jeffraines/battlebuddy/docs/roadmap.md

# Roadmap

Two products from one device:

- **Personal:** one counter per player (or one shared per table). Bought by players.
- **Store / tournament kit:** a set of devices (e.g. 8, 16 or 32) plus a hub, a
  charging tray, and a live dashboard. Bought by stores. Smaller "friends"
  kits (e.g. 4 for a Commander pod) sit in between.

The personal device comes first. The kit shapes a few early hardware choices
(radio, battery, charging, device ID) so PCB v1 doesn't paint us into a corner.

## Design principles

These apply to everything built here, not just BattleBuddy.

1. **The battery is user-replaceable, without tools beyond a coin or a common
   screwdriver.** A dead battery must never make the device e-waste. Prefer a
   standard, widely sold cell or pack over a custom pouch cell.
2. **Repairable.** Screws, not glue. The display, battery and buttons connect
   with connectors, not solder. Spare parts and firmware stay available.
3. **Spill-tolerant, not waterproof.** It should survive a knocked-over drink
   on the table. No official IP rating needed (and don't claim one without testing).

### Replaceable battery options

| Option | Pros | Cons |
|---|---|---|
| Phone-style flat pack (e.g. Nokia BL-5C type, 3.7 V ~1000 mAh, ~53×34×6 mm) | Flat, protected, keyed, spring contacts, sold almost everywhere | Long-term availability of a specific pack type; check it fits each design |
| Small cylindrical Li-ion in a holder (10440 / 16340 / 18650) | Standard sizes, easy to buy, holder is cheap | Thicker; 10440/14500 look like AAA/AA, so mixing them up is a risk |
| 2× AA / AAA (NiMH or alkaline) | Most universal; nothing to charge if you don't want to | Needs a boost converter; bulkier; best for low-power displays (e-paper, reflective) |
| Flat LiPo with a JST plug behind a battery door | Thinnest; what the LilyGO prototype uses | Exact replacement is harder to find; must label size and polarity |

Leaning: a phone-style flat pack for the personal device, an 18650 for a larger
"Max" model.

### Spill tolerance

- A gasket between the display and the enclosure lip; buttons under a
  membrane or with sealed caps.
- USB-C mounted so liquid doesn't run into it (side-facing, recessed), and a
  battery door with a simple seal.
- Conformal coating on the PCB: cheap, and it handles the "wiped it off and it
  still works" case.
- Firmware: ignore touches that look like water (many points at once, large
  contact areas) and offer a touch lock.

### Regulation note

The EU Battery Regulation (2023/1542) requires portable batteries in most
appliances to be removable and replaceable by the end user from February 2027.
That matters if this is ever sold in Europe, and principle 1 already covers it.

## Phases

1. **Prototype firmware** on the LilyGO T-Display-S3 Touch, and play-test it at
   real games. *(In progress: `firmware/tdisplay-s3`.)*
2. **Pick the display and MCU** using the display test kit and battery
   measurements (see `hardware.md`).
3. **PCB v1:** see `pcb-v1.md` for the running requirements list (fuel gauge,
   replaceable battery, wireless charging, display on connectors, and more).
   Designed for low standby current (regulator and charger quiescent current
   matter as much as the MCU's sleep current).
4. **Enclosure:** 3D printed first; injection molding only once the design
   settles. Screwed together, with a tool-light battery door and a display gasket.
5. **Configuration:** phone/web configurator, custom game profiles, sharing.
6. **Tournament kit:** hub, server and dashboard, pairings import, charging tray.

## Tournament mode (concept)

- A tournament server (laptop, Raspberry Pi or cloud) holds players, pairings
  and the round clock.
- Each device has a unique ID (from the chip) and is checked in to a player.
- At round start the server pushes table number, opponent name and a synced
  round timer to each device.
- Score changes stream to the server; a web page shows every table live.
- Both players confirm the result on the device, replacing the match slip.
- Import pairings from existing tournament software rather than replacing it.

### Radio options

| Option | Fits | Notes |
|---|---|---|
| Wi-Fi to a router the store brings | ESP32 | Simplest to build and debug. Avoid venue Wi-Fi (captive portals, flaky). Wi-Fi bursts cost battery, so send small updates and idle the radio. |
| ESP-NOW to one ESP32 hub on the laptop | ESP32 | No router, low latency, good range. |
| BLE advertising to a hub (connectionless) | nRF52 / ESP32 | Each device broadcasts its score; the hub scans, so 32 devices are fine. Pairings go out over short connections. Lowest power; keeps the Nordic option alive. |

A hub is needed in every case. Classic BLE connections to one central don't
scale to 32 devices.

## MCU decision (open)

The MCU is $1–4 of the bill of materials, so pick for headroom; the battery
budget is decided mostly by the display and the board's power design.

| | ESP32-S3 | ESP32-C3 / C6 | nRF52840 |
|---|---|---|---|
| Radios | Wi-Fi + BLE | Wi-Fi + BLE (C6 adds 802.15.4) | BLE (+ proprietary 2.4 GHz) |
| RAM / display | 512 KB + PSRAM, parallel LCD | 400–512 KB, SPI LCD | 256 KB, SPI LCD |
| Sleep | Good (~10 µA chip) | Good | Best |
| Tournament path | Wi-Fi or ESP-NOW | Wi-Fi or ESP-NOW | BLE advertising |

The counter logic (`core/`) is portable C, so either family stays possible.
Decide at PCB time based on measured battery life and which tournament radio
path proves out.

## Charging tray (open)

| Option | Pros | Cons |
|---|---|---|
| Qi receiver per device, one transmitter per tray slot | Sealed enclosure, nice UX | A transmitter per slot adds cost; heat |
| One loosely coupled resonant coil charging several devices | True "drop them on the tray" | Less standard, efficiency varies with placement |
| Pogo pins / magnetic contacts | Cheapest, efficient, simple | Exposed contacts; needs alignment |
