jeffraines/battlebuddy/docs/size-cutouts.pdf

# BattleBuddy - actual-size display cutouts

Print at 100% / Actual size. The bar below must measure 50 mm. Outlines are the visible screen only; boards and cases are larger.

50 mm
20

1.47" LCD (Waveshare C6)
320x172, 33 x 18 mm active area

20

1.54" IPS - the one you own 240x240, 28 x 28 mm active area

20

1.8" AMOLED
448x368, 35 x 29 mm active area
20

1.9" LCD (T-Display S3)
320x170, 43 x 23 mm active area

20

2.0" LCD (Estardyn)
320x240, 41 x 30 mm active area

20

2.13" e-paper / reflective 250x122, 49 x 24 mm active area

2.41" AMOLED

20

600x450, 49 x 37 mm active area

2.7" Sharp Memory LCD

20

400x240, 59 x 35 mm active area
20

2.79" bar LCD (Estardyn)
428x142, 67 x 22 mm active area

2.8" LCD (Cheap Yellow)

20

320x240, 57 x 43 mm active area
20

2.9" e-paper (WeAct)
296x128, 68 x 29 mm active area

20

2.8" LCD - shared
320x240, 57 x 43 mm active area

20

3.5" LCD - shared
480x320, 74 x 49 mm active area
20

4.2" reflective (Osptek) - shared 400x300, 85 x 64 mm active area
