jeffraines/battlebuddy/enclosure/fitcheck.stl

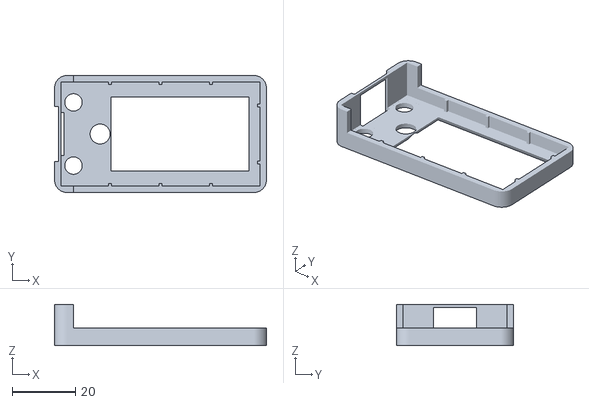
[picture p3: CAD file, 2026-11-08]
enclosure/fitcheck.stl
67.0 x 37.0 x 13.1
