jeffraines/battlebuddy/enclosure/stl/faceplate_r24_split-faceplate-body-separator.stl

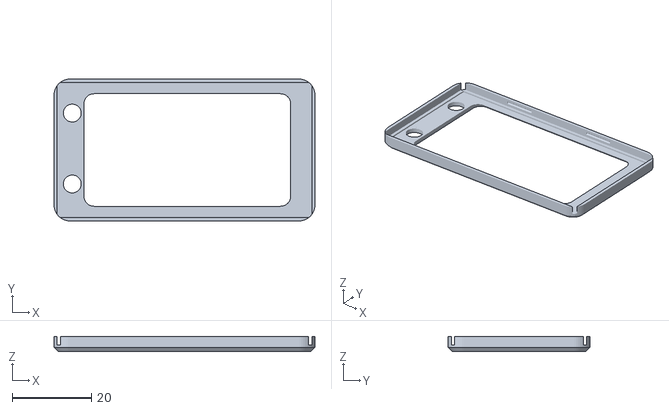
[picture p4: CAD file, 2026-11-14]
enclosure/stl/faceplate_r24_split-faceplate-body-separator.stl
65.7 x 35.7 x 3.70
