jeffraines/battlebuddy/enclosure/shell.stl

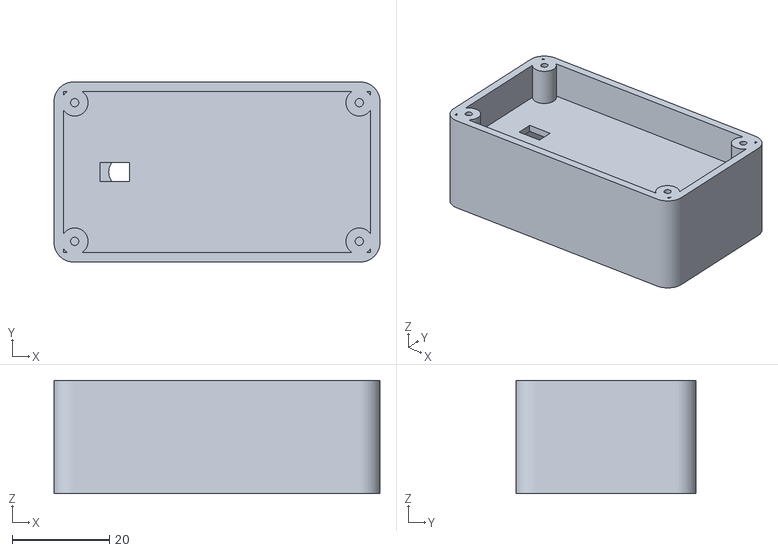
[picture p5: CAD file, 2026-11-08]
enclosure/shell.stl
67.0 x 37.0 x 23.3
