jeffraines/battlebuddy/enclosure/stl/separator_r24_split-faceplate-body-separator.stl

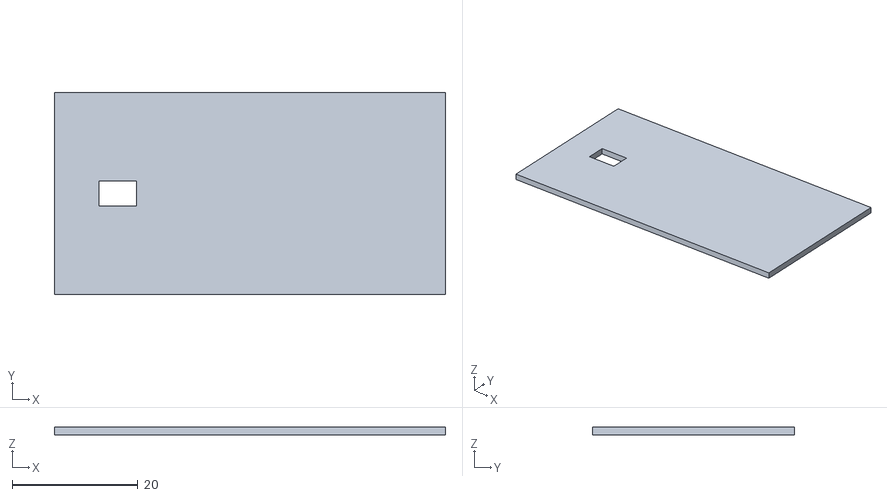
[picture p6: CAD file, 2026-11-14]
enclosure/stl/separator_r24_split-faceplate-body-separator.stl
62.1 x 32.1 x 1.20
