jeffraines/battlebuddy/enclosure/lid.stl

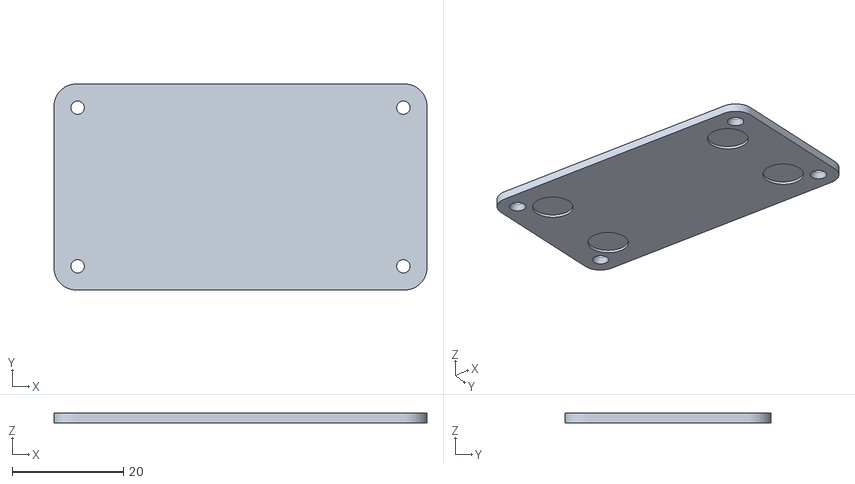
[picture p7: CAD file, 2026-11-08]
enclosure/lid.stl
67.0 x 37.0 x 1.80
