jeffraines/battlebuddy/enclosure/stl/lid_r24_split-faceplate-body-separator.stl

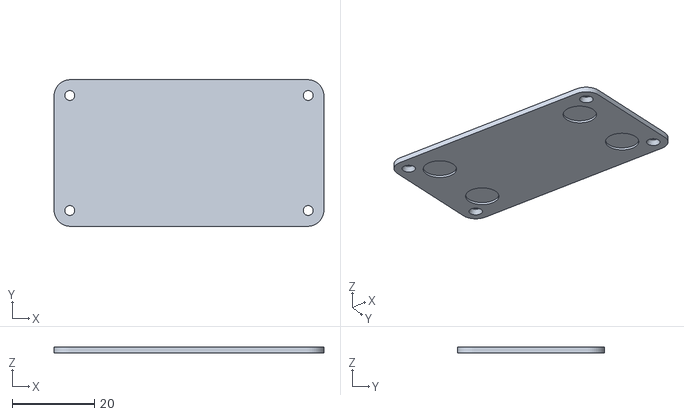
[picture p8: CAD file, 2026-11-14]
enclosure/stl/lid_r24_split-faceplate-body-separator.stl
65.7 x 35.7 x 1.40
