jeffraines/battlebuddy/enclosure/stl/buttons_r24_split-faceplate-body-separator.stl

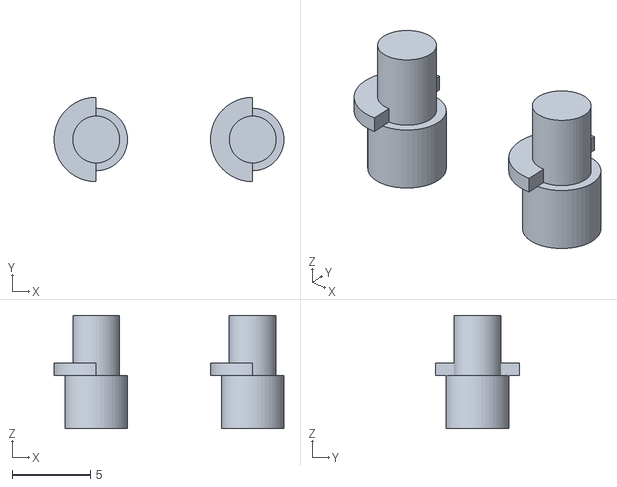
[picture p9: CAD file, 2026-11-14]
enclosure/stl/buttons_r24_split-faceplate-body-separator.stl
14.7 x 5.40 x 7.25
