jeffraines/battlebuddy/enclosure/stl/body_r24_split-faceplate-body-separator.stl

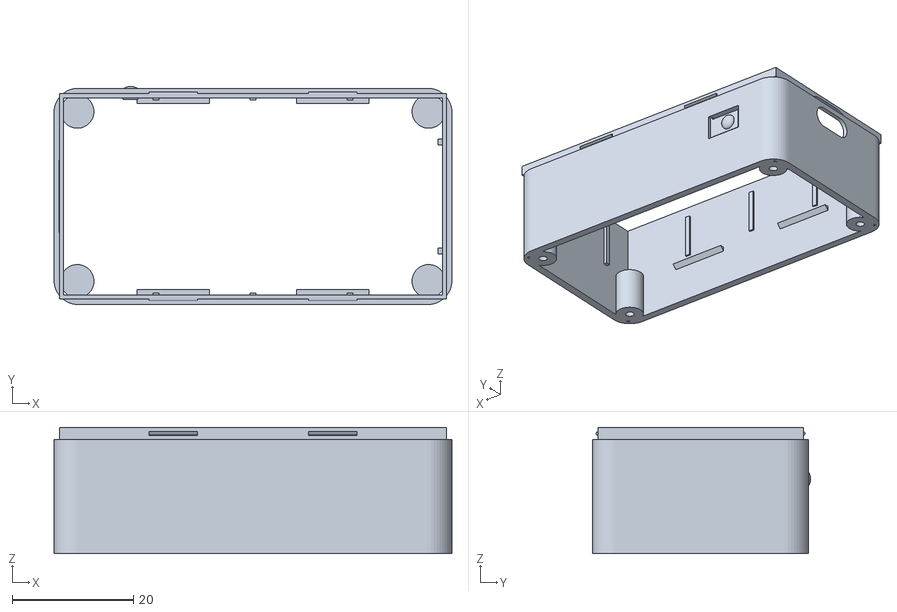
[picture p10: CAD file, 2026-11-14]
enclosure/stl/body_r24_split-faceplate-body-separator.stl
65.7 x 36.0 x 20.8
