jeffraines/battlebuddy/enclosure/stl/fitcheck_r23_flex-reset-button.stl

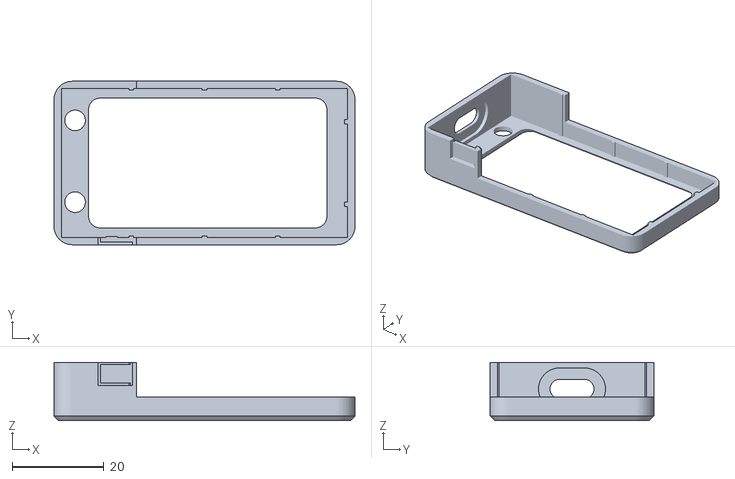
[picture p11: CAD file, 2026-11-14]
enclosure/stl/fitcheck_r23_flex-reset-button.stl
65.7 x 35.7 x 12.7
