jeffraines/battlebuddy/enclosure/stl/shell_r23_flex-reset-button.stl

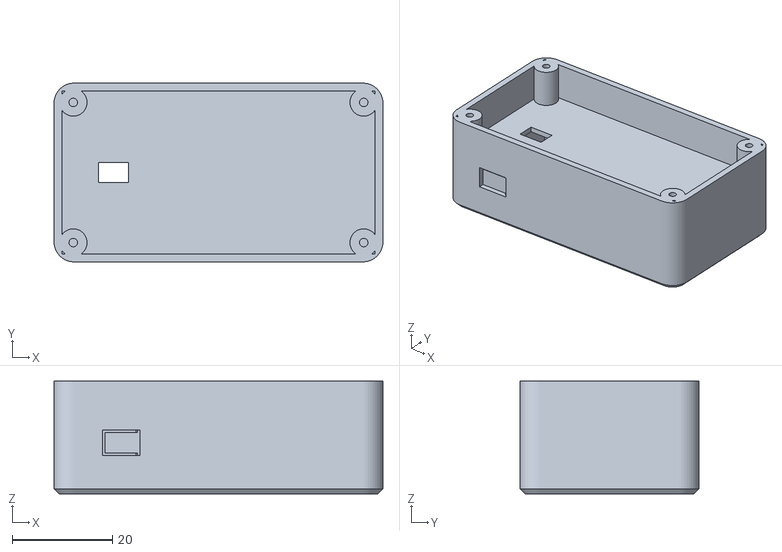
[picture p12: CAD file, 2026-11-14]
enclosure/stl/shell_r23_flex-reset-button.stl
65.7 x 35.7 x 22.5
