jeffraines/battlebuddy/enclosure/stl/buttons_r22_variant-longer-0.3mm.stl

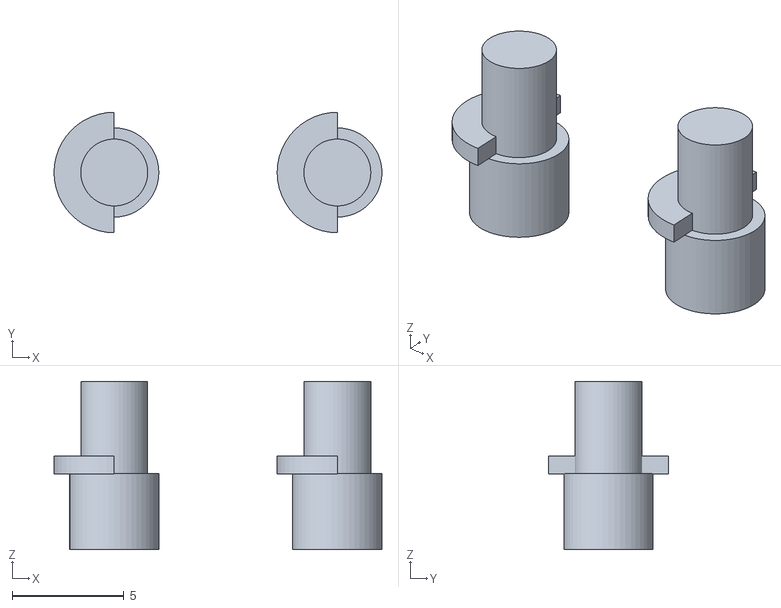
[picture p13: CAD file, 2026-11-14]
enclosure/stl/buttons_r22_variant-longer-0.3mm.stl
14.7 x 5.40 x 7.55
