jeffraines/battlebuddy/enclosure/stl/buttons_r22_variant-shorter-0.3mm.stl

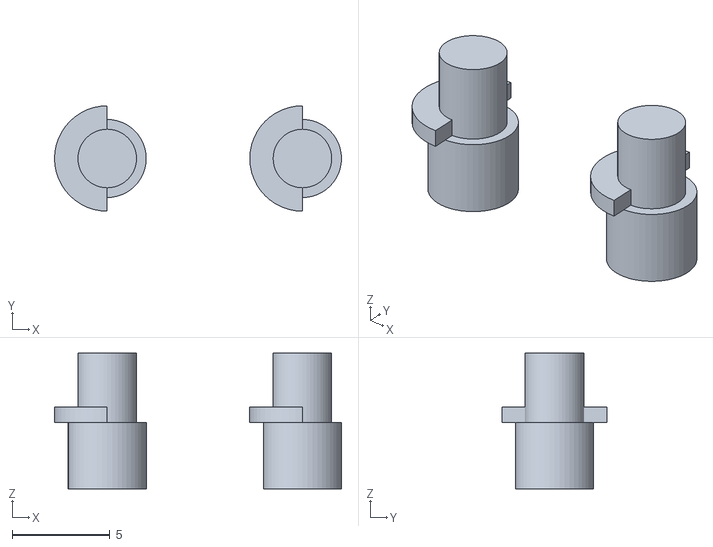
[picture p14: CAD file, 2026-11-14]
enclosure/stl/buttons_r22_variant-shorter-0.3mm.stl
14.7 x 5.40 x 6.95
