jeffraines/battlebuddy/enclosure/stl/fitcheck_r22_final-print-buttons-up-thicker-web.stl

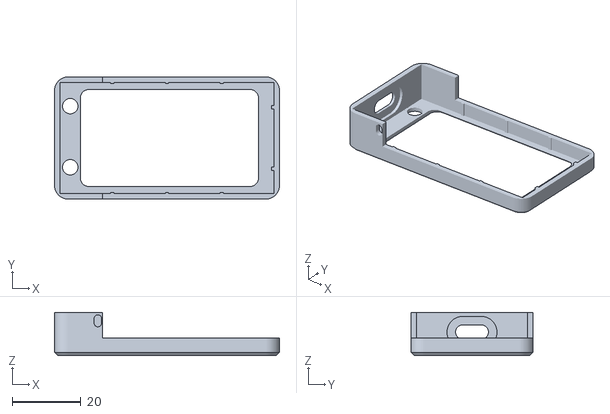
[picture p15: CAD file, 2026-11-14]
enclosure/stl/fitcheck_r22_final-print-buttons-up-thicker-web.stl
65.7 x 35.7 x 12.7
