jeffraines/battlebuddy/enclosure/stl/buttons_r21_button-nudge-window-closer-reset-hole.stl

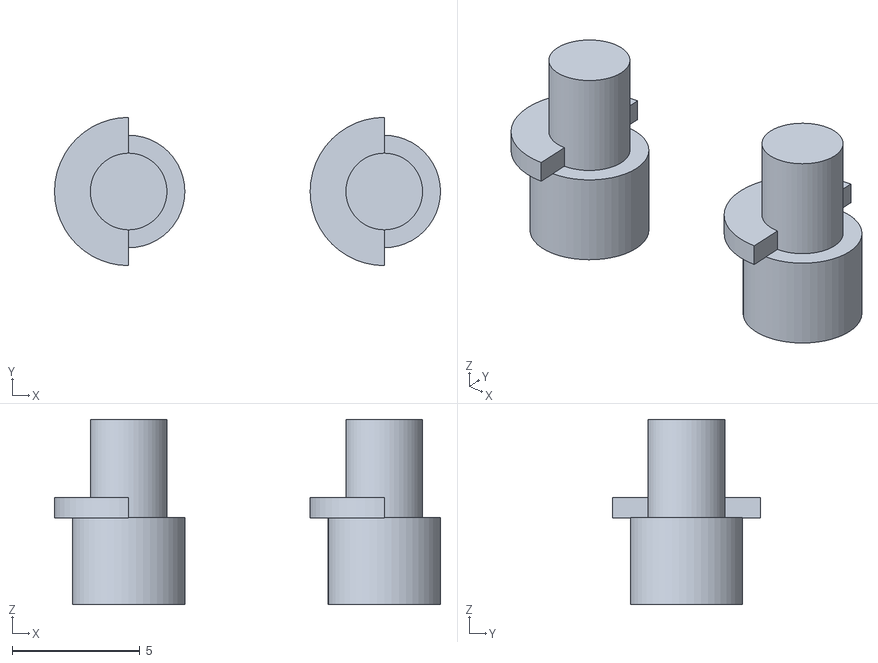
[picture p16: CAD file, 2026-11-14]
enclosure/stl/buttons_r21_button-nudge-window-closer-reset-hole.stl
15.1 x 5.80 x 7.25
