jeffraines/battlebuddy/enclosure/stl/fitcheck_r20_buttons-toward-usb-shorter-taller-caps.stl

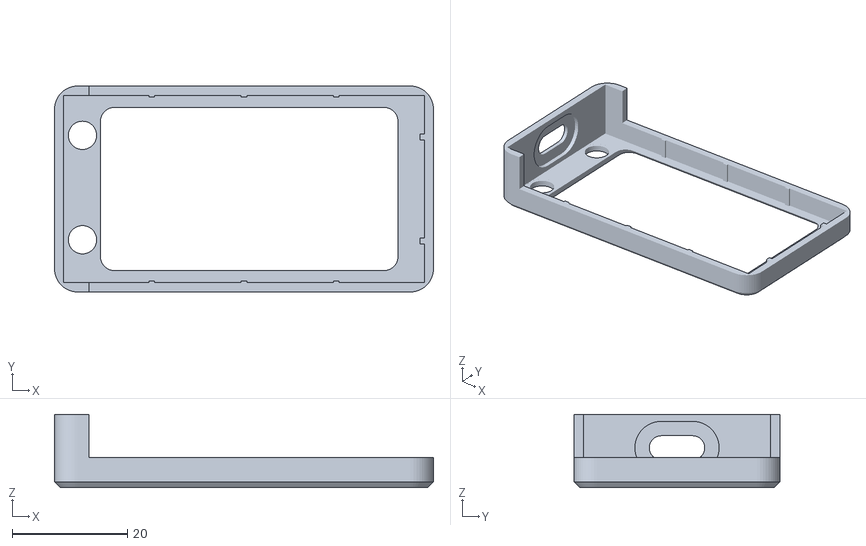
[picture p18: CAD file, 2026-11-10]
enclosure/stl/fitcheck_r20_buttons-toward-usb-shorter-taller-caps.stl
65.7 x 35.7 x 12.7
