jeffraines/battlebuddy/enclosure/stl/buttons_r20_variant-shorter-0.3mm.stl

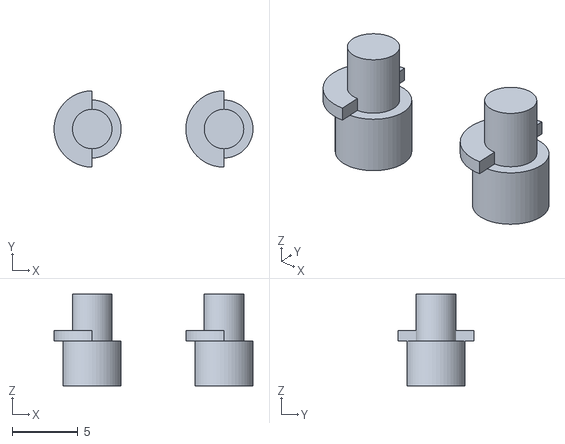
[picture p19: CAD file, 2026-11-10]
enclosure/stl/buttons_r20_variant-shorter-0.3mm.stl
15.1 x 5.80 x 6.95
