jeffraines/battlebuddy/enclosure/stl/buttons_r19_variant-shorter-0.3mm.stl

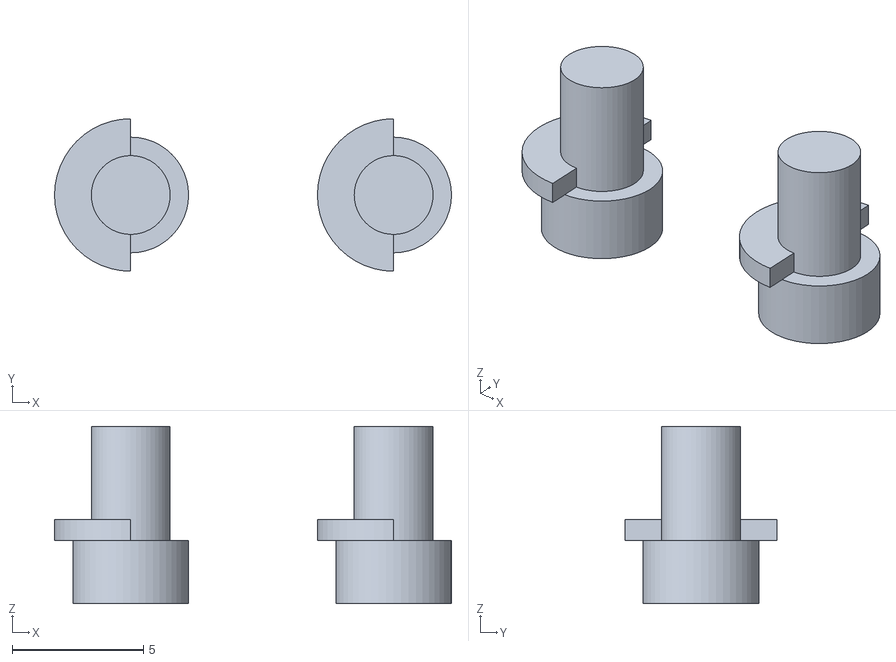
[picture p20: CAD file, 2026-11-10]
enclosure/stl/buttons_r19_variant-shorter-0.3mm.stl
15.1 x 5.80 x 6.75
