jeffraines/battlebuddy/enclosure/stl/fitcheck_r19_window-to-buttons-half-flange.stl

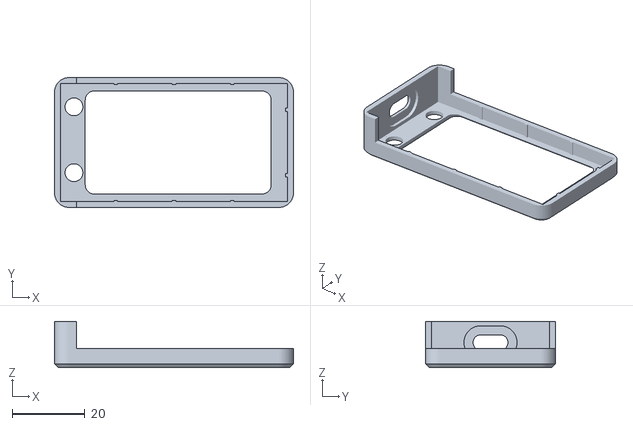
[picture p21: CAD file, 2026-11-10]
enclosure/stl/fitcheck_r19_window-to-buttons-half-flange.stl
65.7 x 35.7 x 12.7
