jeffraines/battlebuddy/enclosure/stl/buttons_r19_window-to-buttons-half-flange.stl

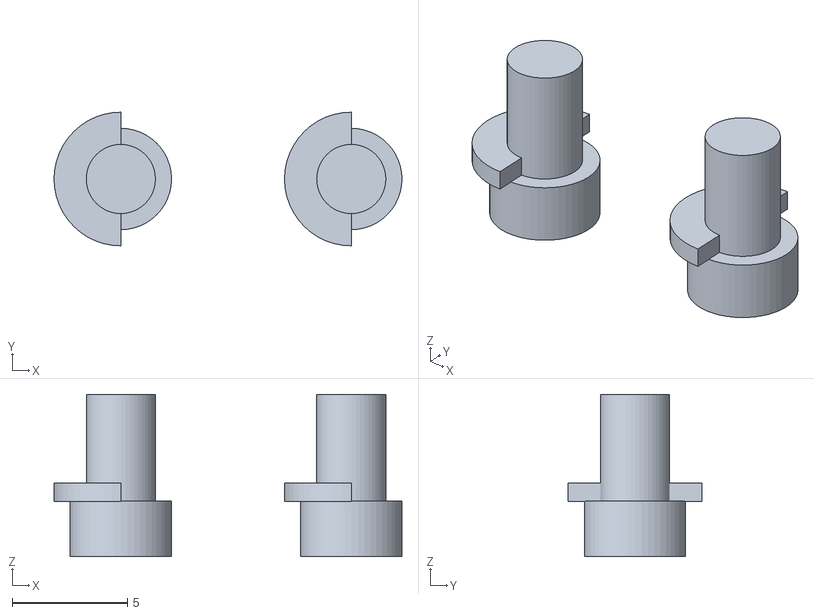
[picture p22: CAD file, 2026-11-10]
enclosure/stl/buttons_r19_window-to-buttons-half-flange.stl
15.1 x 5.80 x 7.05
