jeffraines/battlebuddy/enclosure/stl/buttons_r18_variant-shorter-0.5mm.stl

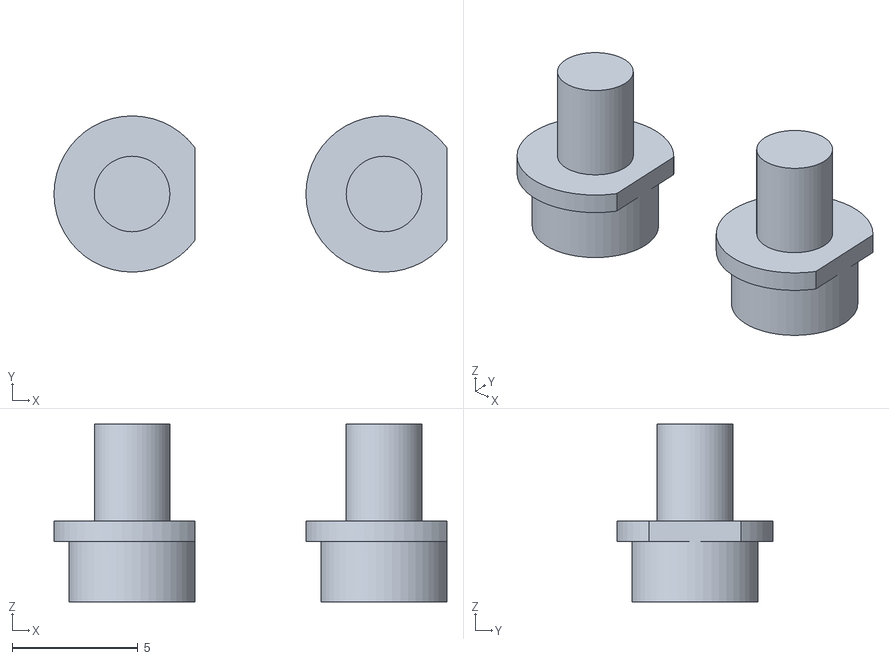
[picture p24: CAD file, 2026-11-09]
enclosure/stl/buttons_r18_variant-shorter-0.5mm.stl
15.6 x 6.20 x 7.05
