jeffraines/battlebuddy/enclosure/stl/buttons_r18_variant-longer-0.5mm.stl

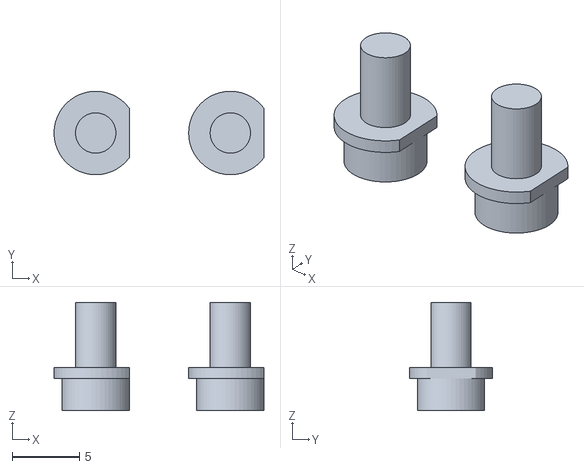
[picture p25: CAD file, 2026-11-09]
enclosure/stl/buttons_r18_variant-longer-0.5mm.stl
15.6 x 6.20 x 8.05
