jeffraines/battlebuddy/enclosure/stl/buttons_r18_window-closer-d-flange-longer-buttons.stl

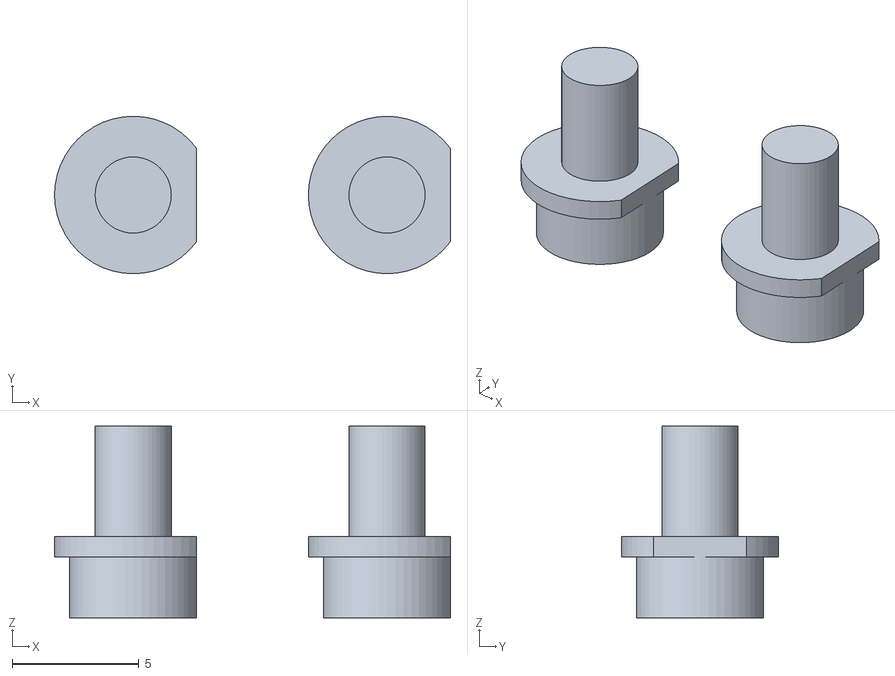
[picture p26: CAD file, 2026-11-09]
enclosure/stl/buttons_r18_window-closer-d-flange-longer-buttons.stl
15.6 x 6.20 x 7.55
