jeffraines/battlebuddy/enclosure/stl/buttons_r17_variant-shorter-0.4mm.stl

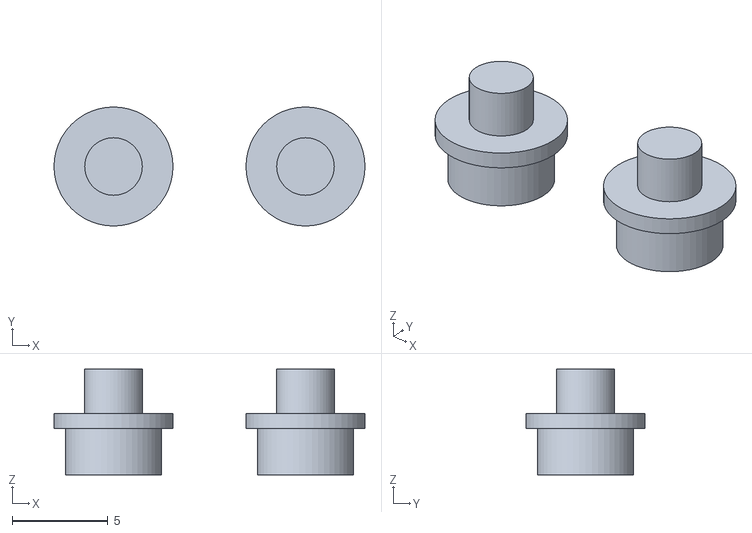
[picture p27: CAD file, 2026-11-09]
enclosure/stl/buttons_r17_variant-shorter-0.4mm.stl
16.2 x 6.20 x 5.50
