jeffraines/battlebuddy/enclosure/stl/buttons_r17_window-to-glass-slim-buttons.stl

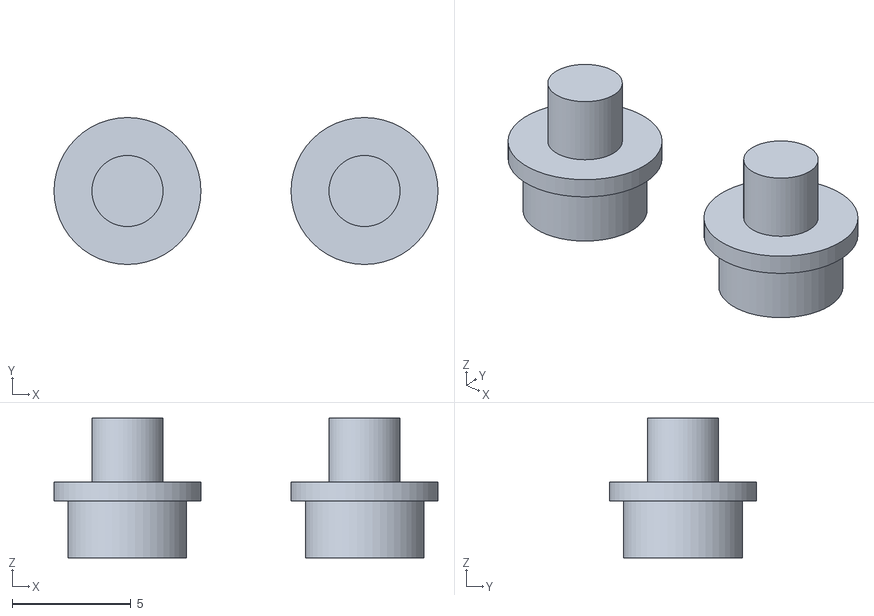
[picture p28: CAD file, 2026-11-09]
enclosure/stl/buttons_r17_window-to-glass-slim-buttons.stl
16.2 x 6.20 x 5.90
