jeffraines/battlebuddy/enclosure/stl/buttons_r16_rounded-tongue-longer-buttons.stl

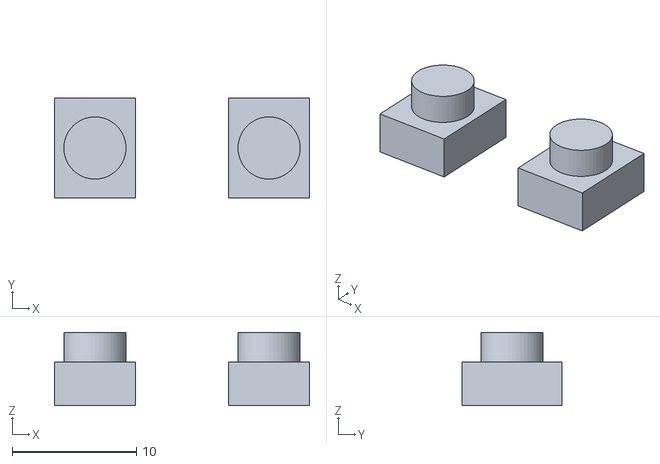
[picture p30: CAD file, 2026-11-09]
enclosure/stl/buttons_r16_rounded-tongue-longer-buttons.stl
20.5 x 8.00 x 5.90
