jeffraines/battlebuddy/enclosure/stl/buttons_r16_variant-shorter-0.4mm.stl

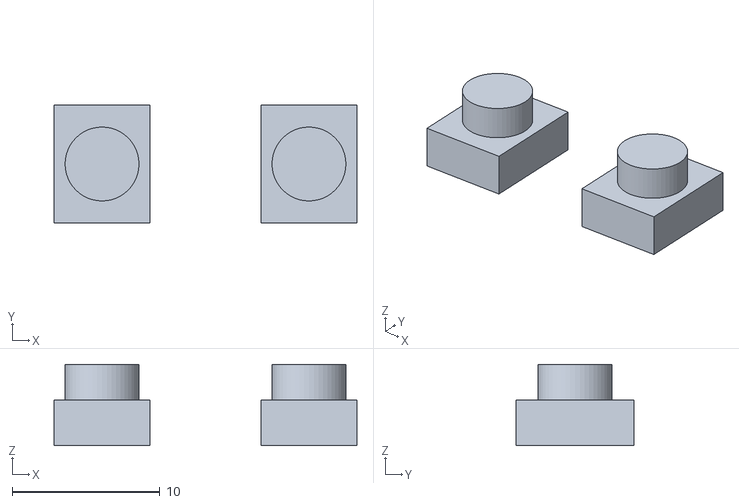
[picture p31: CAD file, 2026-11-09]
enclosure/stl/buttons_r16_variant-shorter-0.4mm.stl
20.5 x 8.00 x 5.50
