jeffraines/battlebuddy/enclosure/stl/buttons_r16_variant-longer-0.4mm.stl

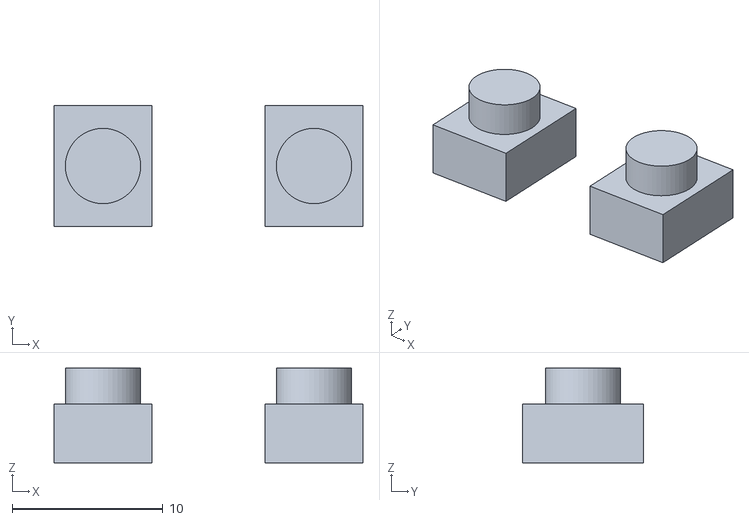
[picture p32: CAD file, 2026-11-09]
enclosure/stl/buttons_r16_variant-longer-0.4mm.stl
20.5 x 8.00 x 6.30
