jeffraines/battlebuddy/enclosure/stl/fitcheck_r13_curved-window-end-over-key.stl

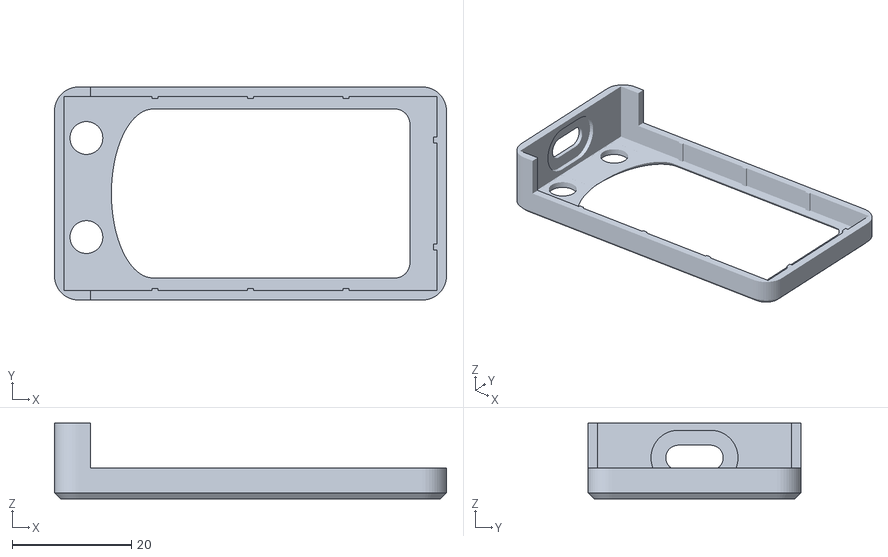
[picture p33: CAD file, 2026-11-09]
enclosure/stl/fitcheck_r13_curved-window-end-over-key.stl
65.7 x 35.7 x 12.7
