jeffraines/battlebuddy/enclosure/stl/shell_r12_asymmetric-buttons-key-notch.stl

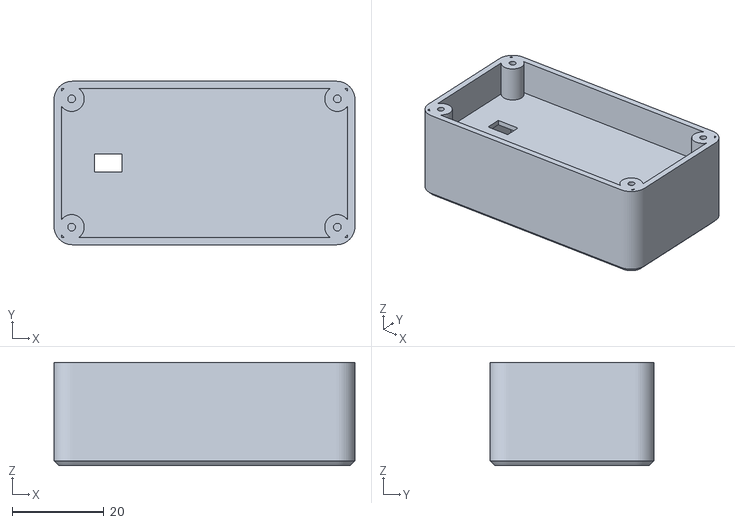
[picture p34: CAD file, 2026-11-09]
enclosure/stl/shell_r12_asymmetric-buttons-key-notch.stl
65.7 x 35.7 x 22.5
