jeffraines/battlebuddy/enclosure/stl/buttons_r15_window-tongue-between-buttons.stl

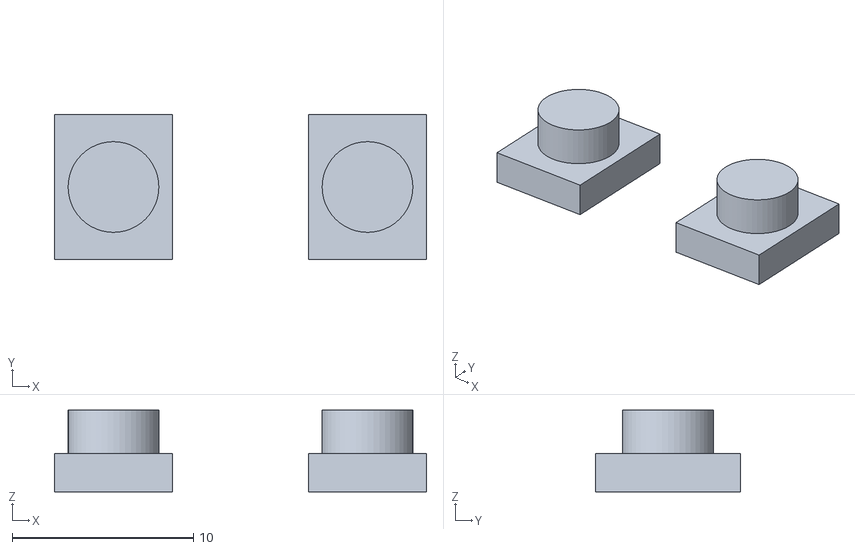
[picture p35: CAD file, 2026-11-08]
enclosure/stl/buttons_r15_window-tongue-between-buttons.stl
20.5 x 8.00 x 4.50
