jeffraines/battlebuddy/enclosure/stl/fitcheck_r09_slimmer-small-usb-snug-ribs.stl

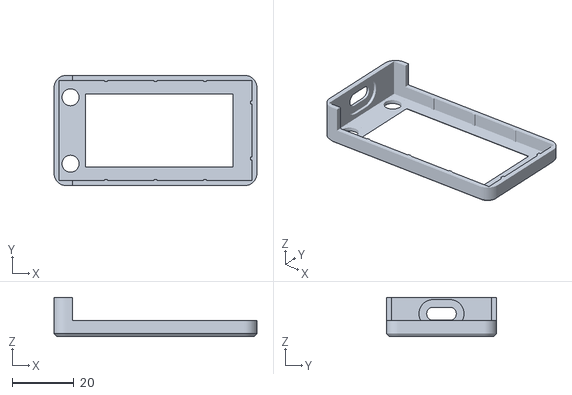
[picture p36: CAD file, 2026-11-08]
enclosure/stl/fitcheck_r09_slimmer-small-usb-snug-ribs.stl
65.7 x 35.7 x 12.7
