jeffraines/battlebuddy/enclosure/stl/fitcheck_r07_rounded-usb-trim-far-bezel.stl

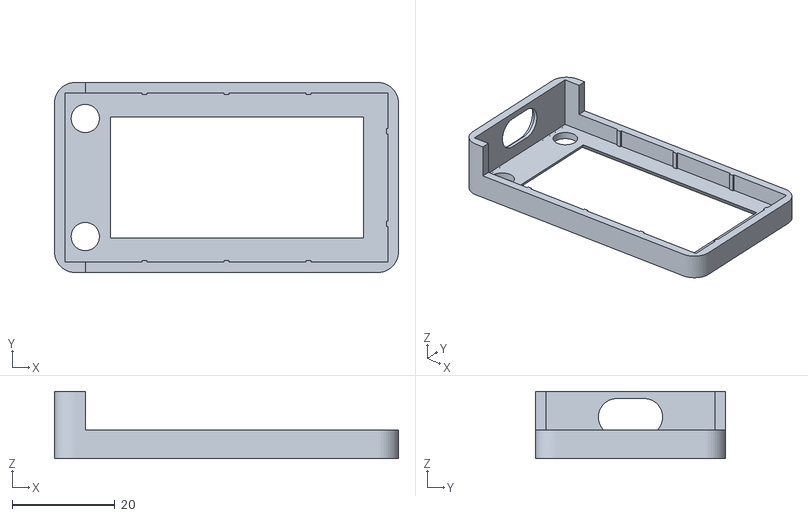
[picture p37: CAD file, 2026-11-08]
enclosure/stl/fitcheck_r07_rounded-usb-trim-far-bezel.stl
67.0 x 37.0 x 13.1
