jeffraines/battlebuddy/enclosure/stl/shell_r06_buttons-out-key-window-looser-ribs.stl

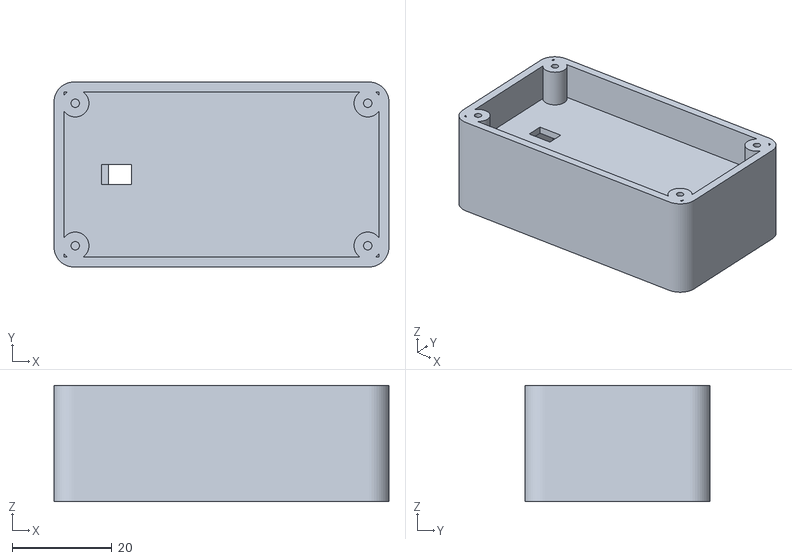
[picture p38: CAD file, 2026-11-08]
enclosure/stl/shell_r06_buttons-out-key-window-looser-ribs.stl
67.0 x 37.0 x 23.3
