jeffraines/battlebuddy/enclosure/stl/fitcheck_r06_buttons-out-key-window-looser-ribs.stl

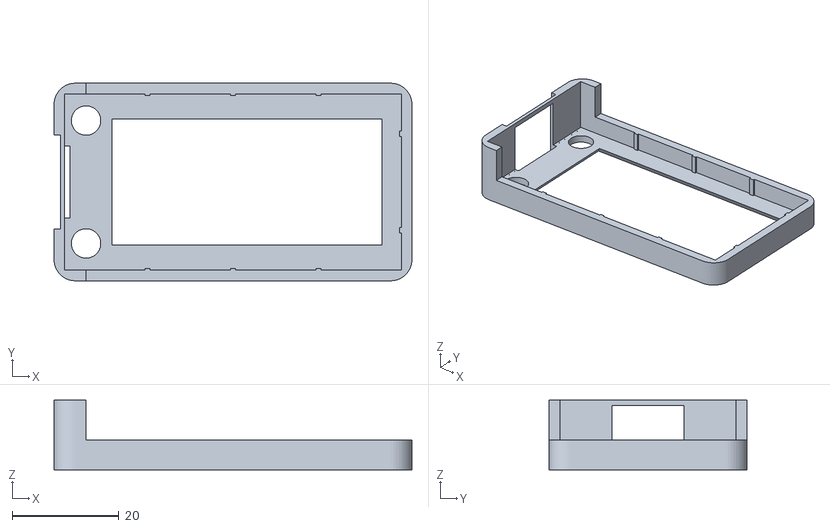
[picture p39: CAD file, 2026-11-08]
enclosure/stl/fitcheck_r06_buttons-out-key-window-looser-ribs.stl
67.0 x 37.0 x 13.1
