jeffraines/battlebuddy/enclosure/stl/buttons_r08_trim-far-bezel-more-usb-up.stl

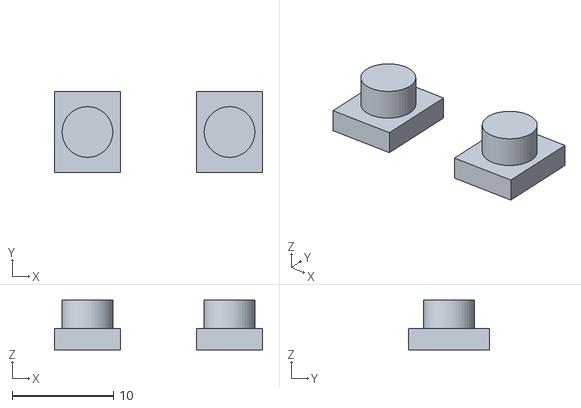
[picture p40: CAD file, 2026-11-08]
enclosure/stl/buttons_r08_trim-far-bezel-more-usb-up.stl
20.5 x 8.00 x 4.90
