jeffraines/battlebuddy/enclosure/lilygo_case.scad

// BattleBuddy prototype case: LilyGO T-Display-S3 Touch + 803040 LiPo
// (8 x 30 x 40 mm, 1000 mAh).
//
// Printed parts plus 4 x M2 x 6 self-tapping screws:
//   shell   - holds the board face-down behind a front window, with the
//             battery in its own bay underneath (print face-down, no supports)
//   lid     - screws onto the back; remove it to swap the battery
//   buttons - press plungers that sit in the side walls and push the board's
//             side buttons (print as laid out, no supports)
//
// Board size is from the Touch version's listing (62 x 32 x 11 mm). The
// screen glass covers most of the front; at the USB end the bare board sticks
// out with the USB-C port in the middle and two face buttons (BOOT, KEY), one
// each side. Exact positions aren't published, so every opening is a parameter.
// MEASURE YOUR BOARD and edit the values marked "measure" before printing,
// or print the fit check first (part = "fitcheck").
//
// Export:  openscad -D 'part="shell"'   -o shell.stl   lilygo_case.scad
//          openscad -D 'part="lid"'     -o lid.stl     lilygo_case.scad
//          openscad -D 'part="buttons"' -o buttons.stl lilygo_case.scad

part = "assembly";
clr_default = 0.5; // "shell", "lid", "buttons", "fitcheck", "assembly" (preview only)

/* [Board: measure] */
board_l = 62;    // length, USB end to far end
board_w = 32;    // width
board_t = 11;    // thickness incl. display, touch glass and parts on the back
tail_l = 8;      // bare board at the USB end, beyond the glass
glass_drop = 4;  // front of the glass down to the board's top surface
switch_depth = 3.55; // face buttons: glass front down to the switch tops
                     // (r19: even the 0.3 mm shorter plunger held the case ~0.5 mm off)
usb_from_front = 5.7;  // front glass to the USB-C centre (the first print showed it sits lower)
lip = 1.2;            // how far the front frame overlaps the glass edge (window_style "glass")

/* [Front window: measure] */
// "screen": the frame covers the glass's black border and shows the display
//           plus the strip below it with the circle touch key, as one window.
// "border": like "screen", but most of the glass's black border shows too, so
//           the plastic frame is thin (best with black filament: glass and
//           frame blend). The board itself is black, so a slight overshoot hides.
// "glass":  the whole glass shows.
window_style = "border";
active_w = 22.7;        // visible display area (1.9" 170x320 panel)
active_l = 42.7;
active_from_far = 6.3;  // far edge of the glass to the start of the display (measure)
screen_margin = 0.4;    // "screen": window this much bigger than the display all round
border_side = 2.8;      // "border": window this much wider than the display on each long side
border_far = 2.0;       //           and this much past it at the far end (r10 2.5 showed a gap)
window_r = 2.5;         // window corner radius, to follow the glass's rounded corners
bevel = 1.2;            // window edges slope outward by this much (room for a fingertip)
bevel_usb = 0;          // smaller slope on the USB-side edge, next to the button holes
key_from_glass = 1.9;   // USB-side edge of the glass to the circle key's centre (from the r08/r10 photos)
cover_key = false;      // true: the frame hides the circle touch key (dice stay in the menu)
key_arch = true;        // with cover_key: the window's USB end sweeps out in a curve over the key
key_arch_past = 2.2;    // the curve's tip reaches this far past the key's centre toward USB
key_cover = 2.3;        // with cover_key, window starts this far past the key's centre
key_room = 4.2;         // without it, window reaches this far past the key's centre toward USB
                        // (r14: as far as the button holes allow, ~0.85 mm of plastic between)
key_tongue = false;     // window also reaches between the two face buttons toward USB
tongue_tip = 3;         // tongue reaches to this far from the board's USB end
tongue_web = 0.7;       // plastic left between the tongue and each button hole (at the surface)
tongue_fillet = 2;      // every corner of the window + tongue outline rounded this much

/* [Fit] */
board_clr = 0.25;       // gap around the board in its pocket (sides and ends)
rib_squeeze = 0.08;     // crush ribs reach this far past the board edge (r05 0.3 bent the screen, r06 -0.15 rattled)
rib = board_clr + rib_squeeze;           // side ribs
end_rib = 2 * board_clr + rib_squeeze + 0.15;  // (r20: +0.15, the board still slid lengthwise)   // far-end ribs: also push the board against the USB end

/* [Buttons: measure] */
// One entry per button:
//   [side, position, kind, across]
//   side: "front" = on the board's face (the T-Display-S3's BOOT and KEY sit
//         either side of the USB port); position = centre in mm from the USB
//         end; across = offset in mm from the centre line (+ = right, looking
//         at the screen with the USB end at the bottom).
//         "left" / "right" = the long edges; position = from the USB end.
//         "end" = the short edge opposite USB; position = offset from centre.
//   kind: "press" = a printed cap that sits on the board's button and pokes out
//         of the case; "pin" = a small recessed hole (so it can't be hit by accident)
// THESE POSITIONS ARE ESTIMATES from product photos. Measure and correct them.
// The board's two switches are not symmetric about its centre line (r11 print).
// r21 (holding it USB-right): top one 0.5 mm down, bottom one 0.25 mm down,
// both 0.25 mm toward USB, on the same line.
// r22: both 0.5 mm up (toward -y).
buttons = [["front", 2.75, "press", -9.3],   // BOOT (GPIO0): menu
           ["front", 2.75, "press", 8.55]];  // KEY (GPIO14): undo

// Reset (RST): a side-push switch on the back of the board, on the +y long
// edge near the USB end. A pinhole slot in the wall (press it with a
// paperclip; a pinhole avoids accidental resets). Position estimated from photos.
rst_style = "flex";       // "flex": press tab moulded into the wall; "pin": paperclip slot; "none"
rst_from_usb = 10.8;      // board's USB end to the switch centre
rst_z_above_back = 2.5;     // switch centre above the back of the board pocket
rst_slot = [2.2, 3.5];    // "pin": slot size (along the case, up-down): room for estimate error
// "flex": a tab cut free on three sides, hinged toward the far end. Pressing it
// bends it in; a small nub on the inside pushes the switch. Recessed so it is
// hard to press by accident. Nothing to print separately or lose.
rst_tab = [6.5, 4];       // tab size (along the case, up-down)
rst_tab_gap = 0.5;        // cut around the tab
rst_tab_free = 2.5;       // tab's free end is this far toward USB from the switch centre
rst_tab_recess = 0.6;     // tab surface sits this far below the wall (also makes it flex)
rst_nub = [2.5, 2, 0.25]; // nub on the inside (along, up-down, reach past the wall's inner face)
rst_bump_d = 3;           // dome on the outside of the tab so a fingertip finds it
rst_bump_h = 0.9;         // (stands ~0.3 mm proud of the wall: findable, not easily knocked)

/* [Split: how it goes together] */
// The case is a body (walls, separator, battery bay) plus a faceplate (the
// front frame and the top of the walls). Assembly: drop the separator plate
// into the body, the board on top of it screen-up, the buttons into the
// faceplate, then snap the faceplate on. Battery and lid go on the back.
// The faceplate is also the part to print in different colours.
split_drop = 2.5;         // seam this far below the inside of the front frame
tongue_t = 0.7;           // body's tongue (inner part of the wall) that the faceplate slips over
tongue_h = 2.0;
tongue_clr = 0.1;
snap_r = 0.3;             // snap ridges on the tongue
snap_len = 8;
ledge = 0.9;              // ledges the separator rests on (plus the screw bosses)   // KEY (GPIO14): undo
button_from_front = 5;   // side / end buttons: front glass to their centre (measure)
button_stick_out = 0.5;  // side / end buttons: how far they stick out past the board edge
face_cap_d = 4.0;        // round cap on face buttons (r19 5 -> 4.4, r22 -> 4.0: thicker wall by the window)
face_flange_d = 5.4;     // face button: thin round flange under the frame (bigger than the hole, keeps it in)
face_flange_t = 0.8;
face_flange_cut = 0;     // flange stops at the cap's centre line: nothing on the display side (r18 still hit the acrylic)
face_stem_d = 3;         // narrow stem from the flange down to the switch (r17: the 6.5 x 8 block hit the display)
cap_l = 7;               // plunger cap, along the case
cap_h = 4;               // plunger cap height
cap_proud = 2.2;         // how far the cap stands out of the wall
plunger_clr = 0.25;      // gap around the cap in its hole
pin_d = 2.2;             // reset pinhole

// Fit check: long slots on both sides instead of buttons, to find positions.
slots_left  = [[4, 30]];
slots_right = [[4, 30]];
slot_h = 6;

/* [Battery] */
batt_l = 40;
batt_w = 30;
batt_t = 8;

/* [Case] */
wall = 1.6;
front = 1.2;      // front frame thickness
edge_ch = 1.0;    // chamfer round the front edge so the case looks thinner
shelf = 1.2;      // separator plate between board and battery
wire_notch_x = 10;   // where the battery wire passes the separator, mm from the USB end
wire_notch = [6, 4]; // notch size (along the case, across)
lid_t = 1.4;
clr = clr_default; // clearance around board and battery
corner_r = 4;
usb_w = 9.6;      // USB-C opening: just the plug's metal shell (8.4 x 2.6) plus room for error
usb_h = 4.2;
usb_web = 0.8;    // wall left round the port (thinned from inside) so the plug housing gets close
screw_pilot = 1.7;  // M2 self-tapping
screw_clear = 2.4;
boss_d = 5.5;

$fn = 48;

// Interior
has_end_buttons = len([for (b = buttons) if (b[0] == "end") b]) > 0;
end_room = has_end_buttons ? (max(board_w, batt_w) - board_w) / 2 + clr : 0;
in_l = max(board_l + end_room + 2 * board_clr, batt_l + 2 * clr);
in_w = max(board_w + 2 * board_clr, batt_w + 2 * clr);
bay_h = batt_t + 0.6;
board_z = bay_h + shelf;              // back of the board pocket
front_z = board_z + board_t + clr;    // inner face of the front frame
out_l = in_l + 2 * wall;
out_w = in_w + 2 * wall;
out_h = front_z + front;
usb_z = front_z - usb_from_front;          // USB-C centre height

// Rounded-rectangle USB slot outline (in the YZ plane after rotation), grown by g.
module usb_slot(g) {
    r = usb_h / 2 + g;
    hull() for (y = [-usb_w / 2 + usb_h / 2, usb_w / 2 - usb_h / 2]) translate([0, y]) circle(r = r, $fn = 48);
}

board_x = wall + board_clr;                     // board sits against the USB end
board_y = wall + (in_w - board_w) / 2;
batt_x = wall + (in_l - batt_l) / 2;      // battery centred, clear of the screw bosses
batt_y = wall + (in_w - batt_w) / 2;

boss_xy = [[wall + boss_d / 2 - 0.5, wall + boss_d / 2 - 0.5],
           [out_l - wall - boss_d / 2 + 0.5, wall + boss_d / 2 - 0.5],
           [wall + boss_d / 2 - 0.5, out_w - wall - boss_d / 2 + 0.5],
           [out_l - wall - boss_d / 2 + 0.5, out_w - wall - boss_d / 2 + 0.5]];

module rounded_box(l, w, h, r) {
    hull() for (x = [r, l - r], y = [r, w - r]) translate([x, y, 0]) cylinder(r = r, h = h);
}

btn_z = front_z - button_from_front;
gap_side = (in_w - board_w) / 2;                 // wall to board edge, long sides
block_l = cap_l + 3;
block_h = cap_h + 3;

// Gap between the inside of the wall and the button on a button's side.
function button_gap(b) = b[0] == "front" ? clr + switch_depth
                       : b[0] == "end" ? out_l - wall - (board_x + board_l) - button_stick_out
                       : gap_side - button_stick_out;
// Wall thickness the cap passes through.
function wall_of(b) = b[0] == "front" ? front : wall;
// Thickness of a cap's inner block (the part that sits on the button).
block_extra = 0;  // lengthen (+) or shorten (-) the button plungers to tune the click
function block_thick(b) = button_gap(b) - 0.2 + block_extra;

// Places children in a button's frame: origin on the outside of the case at
// the button's centre, +y pointing into the case.
module at_button(b) {
    if (b[0] == "front")
        translate([board_x + b[1], board_y + board_w / 2 + b[3], out_h]) rotate([-90, 0, 0]) children();
    else if (b[0] == "left")
        translate([board_x + b[1], 0, btn_z]) children();
    else if (b[0] == "right")
        translate([board_x + b[1], out_w, btn_z]) mirror([0, 1, 0]) children();
    else
        translate([out_l, board_y + board_w / 2 + b[1], btn_z]) rotate([0, 0, 90]) children();
}

// Hole through the wall (and the pocket behind it) for one button.
module button_hole(b) {
    w = wall_of(b);
    at_button(b) {
        if (b[2] == "pin") {
            translate([0, -1, 0]) rotate([-90, 0, 0]) cylinder(d = pin_d, h = w + button_gap(b) + 2);
        } else if (b[0] == "front") {
            translate([0, -1, 0]) rotate([-90, 0, 0]) cylinder(d = face_cap_d + 2 * plunger_clr, h = w + 2);
            translate([0, w - 0.01, 0]) rotate([-90, 0, 0]) intersection() {
                cylinder(d = face_flange_d + 0.6, h = face_flange_t + 0.4);
                translate([-10, -10, 0]) cube([10 + face_flange_cut + 0.3, 20, 5]);
            }
        } else {
            translate([-cap_l / 2 - plunger_clr, -1, -cap_h / 2 - plunger_clr])
                cube([cap_l + 2 * plunger_clr, w + 2, cap_h + 2 * plunger_clr]);
            translate([-block_l / 2 - 0.3, w - 0.01, -block_h / 2 - 0.3])
                cube([block_l + 0.6, button_gap(b) + 0.01, block_h + 0.6]);
        }
    }
}

// A press button: a cap that pokes out of the case, on an inner block that is
// bigger than the hole (so it can't fall out) and sits on the board's button.
module plunger(b) {
    t = block_thick(b);
    w = wall_of(b);
    if (b[0] == "front") {
        translate([0, w, 0]) rotate([-90, 0, 0]) {
            intersection() {   // D-shaped: flat on the display side
                cylinder(d = face_flange_d, h = face_flange_t);
                translate([-10, -10, 0]) cube([10 + face_flange_cut, 20, 5]);
            }
            cylinder(d = face_stem_d, h = t);
        }
        translate([0, -cap_proud, 0]) rotate([-90, 0, 0]) cylinder(d = face_cap_d, h = w + cap_proud + 0.01);
    } else {
        translate([-block_l / 2, w, -block_h / 2]) cube([block_l, t, block_h]);
        translate([-cap_l / 2, -cap_proud, -cap_h / 2]) cube([cap_l, w + cap_proud + 0.01, cap_h]);
    }
}

// Window outline at the glass with a tongue toward USB between y = lo..hi,
// all corners rounded (fillet radius tongue_fillet), convex and concave.
module window_outline(wx, wy, wl, ww, tx, lo, hi) {
    f = tongue_fillet;
    offset(r = -f) offset(delta = f)      // round the inside corners
        offset(r = f) offset(delta = -f)  // round the outside corners
            union() {
                translate([wx, wy]) square([wl, ww]);
                translate([tx, lo]) square([wx + window_r + 1 - tx, hi - lo]);
            }
}

// Half-ellipse end of the window: ww wide at x = wx, reaching depth toward USB; grown by g.
module window_arch(wx, ww, depth, g, z, h)
    translate([wx, out_w / 2, z]) scale([(depth + g) / (ww / 2 + g), 1, 1]) cylinder(r = ww / 2 + g, h = h, $fn = 120);

module shell(with_slots = false) {
    difference() {
        hull() {
            rounded_box(out_l, out_w, out_h - edge_ch, corner_r);
            translate([edge_ch, edge_ch, 0]) rounded_box(out_l - 2 * edge_ch, out_w - 2 * edge_ch, out_h, corner_r - edge_ch);
        }

        // Battery bay (open at the back, closed by the lid).
        translate([wall, wall, -1]) cube([in_l, in_w, bay_h + 1]);

        // Board pocket.
        translate([wall, wall, board_z]) cube([in_l, in_w, front_z - board_z]);

        // Front window.
        if (window_style == "screen" || window_style == "border") {
            // The display (and optionally the circle key), as one bevelled, rounded window.
            key_x = board_x + tail_l + key_from_glass;
            wx = cover_key ? key_x + key_cover : key_x - key_room;
            side = window_style == "border" ? border_side : screen_margin;
            far = window_style == "border" ? border_far : screen_margin;
            wy = out_w / 2 - active_w / 2 - side;
            wl = board_x + board_l - active_from_far + far - wx;
            ww = active_w + 2 * side;
            if (!cover_key && key_tongue) {
                // Window plus a tongue between the face buttons, as one outline with
                // every corner rounded (inside corners too), bevelled in print-layer
                // steps,.
                offs = [for (b = buttons) if (b[0] == "front") b[3]];
                hole_r = face_cap_d / 2 + plunger_clr;
                lo = board_y + board_w / 2 + max([for (o = offs) if (o < 0) o]) + hole_r + tongue_web + bevel;
                hi = board_y + board_w / 2 + min([for (o = offs) if (o > 0) o]) - hole_r - tongue_web - bevel;
                tx = board_x + tongue_tip;
                steps = ceil(front / 0.2);
                for (k = [0 : steps - 1])
                    translate([0, 0, front_z + k * front / steps])
                        linear_extrude(front / steps + 0.01)
                            offset(delta = bevel * (k + 1) / steps) window_outline(wx, wy, wl, ww, tx, lo, hi);
                translate([0, 0, front_z - 1]) linear_extrude(1.02) window_outline(wx, wy, wl, ww, tx, lo, hi);
            } else {
                hull() {
                    translate([wx, wy, front_z - 0.01]) rounded_box(wl, ww, 0.01, window_r);
                    translate([wx - bevel_usb, wy - bevel, out_h]) rounded_box(wl + bevel + bevel_usb, ww + 2 * bevel, 0.01, window_r + bevel_usb);
                }
                translate([wx, wy, front_z - 1]) rounded_box(wl, ww, 1.02, window_r);
            }
            // Curved (half-ellipse) USB end: full window width at the corners,
            // sweeping out to a tip just past the circle key.
            if (cover_key && key_arch) {
                ax = wx + window_r;   // start past the rounded corners so the curve joins smoothly
                depth = ax - (key_x - key_arch_past);
                hull() {
                    window_arch(ax, ww, depth, 0, front_z - 0.01, 0.01);
                    window_arch(ax, ww, depth, bevel, out_h, 0.01);
                }
                window_arch(ax, ww, depth, 0, front_z - 1, 1.02);
            }
        } else {
            // The whole glass (the frame covers the bare board at the USB end).
            translate([board_x + tail_l + lip, board_y + lip, front_z - 1])
                cube([board_l - tail_l - 2 * lip, board_w - 2 * lip, front + 2]);
        }

        // Small notch in the separator for the battery wire.
        translate([board_x + wire_notch_x - wire_notch[0] / 2, out_w / 2 - wire_notch[1] / 2, bay_h - 1])
            cube([wire_notch[0], wire_notch[1], shelf + 2]);

        // USB-C at the board end.
        // Reset pinhole slot in the +y long wall.
        if (rst_style == "pin")
            translate([board_x + rst_from_usb, out_w + 1, board_z + rst_z_above_back]) rotate([90, 0, 0])
                hull() for (dz = [-1, 1]) translate([0, dz * (rst_slot[1] - rst_slot[0]) / 2, 0])
                    cylinder(d = rst_slot[0], h = wall + 2, $fn = 32);
        if (rst_style == "flex") {
            x0 = board_x + rst_from_usb - rst_tab_free;   // free end
            x1 = x0 + rst_tab[0];                          // hinge
            zc = board_z + rst_z_above_back;
            g = rst_tab_gap;
            difference() {   // U-shaped cut through the wall round the tab
                translate([x0 - g, out_w - wall - 1, zc - rst_tab[1] / 2 - g]) cube([x1 - x0 + g, wall + 2, rst_tab[1] + 2 * g]);
                translate([x0, out_w - wall - 1, zc - rst_tab[1] / 2]) cube([x1 - x0 + 1, wall + 2, rst_tab[1]]);
            }
            // Recess the tab's outer face so it is thinner (flexes) and sits below the wall.
            translate([x0 - g, out_w - rst_tab_recess, zc - rst_tab[1] / 2 - g]) cube([x1 - x0 + 2 * g, 1, rst_tab[1] + 2 * g]);
        }

        usb_cuts();

        if (with_slots) {
            // Fit check: long slots in both long walls.
            for (s = slots_left)
                translate([board_x + s[0], -1, btn_z - slot_h / 2]) cube([s[1] - s[0], wall + 2, slot_h]);
            for (s = slots_right)
                translate([board_x + s[0], out_w - wall - 1, btn_z - slot_h / 2]) cube([s[1] - s[0], wall + 2, slot_h]);
        } else {
            for (b = buttons) button_hole(b);
        }
    }

    // Side rails that centre the narrower board in the pocket.
    rail = (in_w - board_w) / 2 - 0.2;
    if (rail > 0.4)
        for (y = [wall, out_w - wall - rail])
            difference() {
                translate([wall, y, board_z]) cube([in_l, rail, front_z - board_z]);
                if (with_slots) {
                    for (s = concat(slots_left, slots_right))
                        translate([board_x + s[0], y - 1, btn_z - slot_h / 2]) cube([s[1] - s[0], rail + 2, slot_h]);
                } else {
                    for (b = buttons) button_hole(b);
                }
                translate([wall - 1, out_w / 2, usb_z]) rotate([0, 90, 0]) linear_extrude(3) usb_slot(0);
            }

    // With buttons on the far end, fill the extra room there so the board can't slide.
    if (has_end_buttons)
        difference() {
            translate([board_x + board_l + 0.2, wall, board_z]) cube([out_l - wall - board_x - board_l - 0.2, in_w, front_z - board_z]);
            for (b = buttons) if (b[0] == "end") button_hole(b);
        }

    // Reset tab's nub, on the inside of the tab, facing the switch.
    if (rst_style == "flex")
        intersection() {   // dome on the outside of the tab
            translate([board_x + rst_from_usb, out_w - rst_tab_recess, board_z + rst_z_above_back])
                scale([1, rst_bump_h / (rst_bump_d / 2), 1]) sphere(d = rst_bump_d, $fn = 32);
            translate([0, out_w - rst_tab_recess, 0]) cube([out_l, 2, out_h]);
        }
    if (rst_style == "flex")
        translate([board_x + rst_from_usb - rst_nub[0] / 2, out_w - wall - rst_nub[2], board_z + rst_z_above_back - rst_nub[1] / 2])
            cube([rst_nub[0], rst_nub[2] + 0.01, rst_nub[1]]);

    // Crush ribs: thin ridges on the inside walls of the board pocket that
    // squash as the board goes in, so it sits snug instead of rattling.
    if (rib > 0) {
        for (x = [board_x + 15, board_x + 31, board_x + 47]) {
            translate([x - 0.5, wall - 0.01, board_z]) cube([1, rib, split_z - 0.2 - board_z]);
            translate([x - 0.5, out_w - wall - rib + 0.01, board_z]) cube([1, rib, split_z - 0.2 - board_z]);
        }
        for (y = [out_w / 2 - 9, out_w / 2 + 9])
            translate([out_l - wall - end_rib + 0.01, y - 0.5, board_z]) cube([end_rib, 1, split_z - 0.2 - board_z]);
    }

    // Screw bosses in the battery bay corners (the battery sits between them).
    for (p = boss_xy)
        translate([p[0], p[1], 0])
            difference() {
                cylinder(d = boss_d, h = bay_h);
                translate([0, 0, -1]) cylinder(d = screw_pilot, h = bay_h);
            }
}

module lid() {
    difference() {
        rounded_box(out_l, out_w, lid_t, corner_r);
        for (p = boss_xy)
            translate([p[0], p[1], -1]) {
                cylinder(d = screw_clear, h = lid_t + 2);
                cylinder(d1 = 4.4, d2 = screw_clear, h = 1.2 + 1); // countersink, outside face
            }
        // Recesses for four 8 mm stick-on rubber feet.
        for (x = [10, out_l - 10], y = [9, out_w - 9])
            translate([x, y, -1]) cylinder(d = 8.6, h = 1.6);
    }
}

// Quick fit check: the front frame with short walls (enough to check the
// outline, window, key hole and button holes), plus the USB end at full
// depth so the port can be checked too. Prints in a fraction of the time.
fit_walls = 4;     // wall height below the front frame
fit_usb_len = 18;  // length of the full-depth piece at the USB end (covers the reset hole too)

split_z = front_z - split_drop;

module usb_cuts() {
    // Small rounded slot for the plug's metal shell only.
    translate([-1, out_w / 2, usb_z]) rotate([0, 90, 0]) linear_extrude(wall + 2) usb_slot(0);
    // Wall thinned from the inside round the port so the plug housing gets close enough to seat.
    translate([usb_web, out_w / 2, usb_z]) rotate([0, 90, 0]) linear_extrude(wall) usb_slot(2.5);
}

// The body's tongue: the inner part of the wall standing above the seam,
// with snap ridges on its long sides. Grown by g to cut the faceplate's groove.
module tongue(g) {
    difference() {
        union() {
            translate([wall - tongue_t - g, wall - tongue_t - g, split_z - 0.01])
                cube([in_l + 2 * (tongue_t + g), in_w + 2 * (tongue_t + g), tongue_h + g + 0.01]);
        }
        e = g > 0 ? 0.05 : 0;   // the faceplate cut reaches a hair into the pocket (no coincident faces)
        translate([wall + e, wall + e, split_z - 1]) cube([in_l - 2 * e, in_w - 2 * e, tongue_h + 3]);
    }
    for (x = [out_l * 0.3, out_l * 0.7], y = [wall - tongue_t, out_w - wall + tongue_t])
        translate([x - snap_len / 2, y, split_z + tongue_h / 2]) rotate([0, 90, 0]) cylinder(r = snap_r + g, h = snap_len, $fn = 16);
}

module body() {
    difference() {
        union() {
            intersection() { shell(); translate([-1, -1, -1]) cube([out_l + 2, out_w + 2, split_z + 1]); }
            difference() { tongue(0); usb_cuts(); }
        }
        // The separator is a separate plate now, so the board can go in from the front.
        translate([wall, wall, bay_h]) cube([in_l, in_w, shelf + 0.01]);
    }
    // Ledges the separator plate rests on, along the long walls (45 deg underneath, no supports).
    for (y = [wall, out_w - wall])
        for (x = [out_l * 0.3, out_l * 0.7])
            translate([x - 6, y, bay_h]) mirror([0, y > out_w / 2 ? 1 : 0, 0])
                translate([0, 0, -ledge]) rotate([90, 0, 90]) linear_extrude(12) polygon([[0, 0], [ledge, ledge], [0, ledge]]);
}

module faceplate() {
    difference() {
        intersection() { shell(); translate([-1, -1, split_z]) cube([out_l + 2, out_w + 2, out_h]); }
        tongue(tongue_clr);
    }
}

module separator() {
    difference() {
        translate([wall + 0.2, wall + 0.2, 0]) cube([in_l - 0.4, in_w - 0.4, shelf]);
        translate([board_x + wire_notch_x - wire_notch[0] / 2, out_w / 2 - wire_notch[1] / 2, -1])
            cube([wire_notch[0], wire_notch[1], shelf + 2]);
    }
}

module fitcheck() {
    intersection() {
        shell();
        union() {
            translate([-1, -1, front_z - fit_walls]) cube([out_l + 2, out_w + 2, out_h]);
            translate([-1, -1, board_z]) cube([fit_usb_len + 1, out_w + 2, out_h]);
        }
    }
}

module board_dummy() {
    color("DimGray") translate([board_x, board_y, board_z + clr]) cube([board_l, board_w, board_t]);
}

module battery_dummy() {
    color("Silver") translate([batt_x, batt_y, 0.3]) cube([batt_l, batt_w, batt_t]);
}

if (part == "shell") {
    // Printed face-down.
    translate([0, out_w, out_h]) rotate([180, 0, 0]) shell();
} else if (part == "lid") {
    lid();
} else if (part == "buttons") {
    // Face buttons stand cap-down on the bed (flat cap face, flange above it);
    // side buttons lie with the inner block on the bed.
    presses = [for (b = buttons) if (b[2] == "press") b];
    for (i = [0 : len(presses) - 1])
        if (presses[i][0] == "front")
            translate([i * 10 + 5, 5, cap_proud]) rotate([90, 0, 0]) plunger(presses[i]);
        else
            translate([i * (block_l + 4) + block_l / 2, block_l / 2, 0])
                rotate([-90, 0, 0]) translate([0, -wall_of(presses[i]) - block_thick(presses[i]), 0]) plunger(presses[i]);
} else if (part == "none") {
    // nothing (for including this file from another)
} else if (part == "body") {
    body();   // printed as it sits: back on the bed
} else if (part == "faceplate") {
    translate([0, out_w, out_h]) rotate([180, 0, 0]) faceplate();   // face-down
} else if (part == "separator") {
    translate([-wall, -wall, 0]) separator();
} else if (part == "fitcheck") {
    translate([0, out_w, out_h]) rotate([180, 0, 0]) fitcheck();
} else {
    color("SteelBlue", 0.85) shell();
    board_dummy();
    battery_dummy();
    for (b = buttons)
        if (b[2] == "press")
            color("Orange") at_button(b) plunger(b);
    color("SlateGray") translate([0, 0, -lid_t - 6]) lid();
}

echo(str("Outer size: ", out_l, " x ", out_w, " x ", out_h + lid_t, " mm"));
