jeffraines/battlebuddy/(list of files, cad)

Other CAD files:
enclosure/stl/buttons_r23_flex-reset-button.stl
enclosure/stl/lid_r23_flex-reset-button.stl
enclosure/stl/shell_r22_final-print-buttons-up-thicker-web.stl
enclosure/stl/buttons_r22_final-print-buttons-up-thicker-web.stl
enclosure/stl/lid_r22_final-print-buttons-up-thicker-web.stl
enclosure/stl/shell_r21_button-nudge-window-closer-reset-hole.stl
enclosure/stl/fitcheck_r21_button-nudge-window-closer-reset-hole.stl
enclosure/stl/buttons_r20_buttons-toward-usb-shorter-taller-caps.stl
enclosure/stl/lid_r20_buttons-toward-usb-shorter-taller-caps.stl
enclosure/stl/shell_r20_buttons-toward-usb-shorter-taller-caps.stl
enclosure/stl/lid_r19_window-to-buttons-half-flange.stl
enclosure/stl/shell_r19_window-to-buttons-half-flange.stl
enclosure/stl/shell_r18_window-closer-d-flange-longer-buttons.stl
enclosure/stl/lid_r18_window-closer-d-flange-longer-buttons.stl
enclosure/stl/fitcheck_r18_window-closer-d-flange-longer-buttons.stl
enclosure/stl/shell_r17_window-to-glass-slim-buttons.stl
enclosure/stl/fitcheck_r17_window-to-glass-slim-buttons.stl
enclosure/stl/lid_r17_window-to-glass-slim-buttons.stl
enclosure/stl/shell_r16_rounded-tongue-longer-buttons.stl
enclosure/stl/fitcheck_r16_rounded-tongue-longer-buttons.stl
enclosure/stl/lid_r16_rounded-tongue-longer-buttons.stl
enclosure/stl/fitcheck_r15_window-tongue-between-buttons.stl
enclosure/stl/shell_r15_window-tongue-between-buttons.stl
enclosure/stl/lid_r15_window-tongue-between-buttons.stl
enclosure/stl/lid_r14_straight-window-to-buttons.stl
enclosure/stl/fitcheck_r14_variant-key-covered.stl
enclosure/stl/fitcheck_r14_straight-window-to-buttons.stl
enclosure/stl/shell_r14_straight-window-to-buttons.stl
enclosure/stl/shell_r13_curved-window-end-over-key.stl
enclosure/stl/lid_r13_curved-window-end-over-key.stl
enclosure/stl/lid_r12_asymmetric-buttons-key-notch.stl
enclosure/stl/fitcheck_r12_asymmetric-buttons-key-notch.stl
enclosure/stl/lid_r11_rounded-window-cover-key-buttons-in.stl
enclosure/stl/shell_r11_rounded-window-cover-key-buttons-in.stl
enclosure/stl/fitcheck_r11_rounded-window-cover-key-buttons-in.stl
enclosure/stl/shell_r10_thin-frame-show-glass-border.stl
enclosure/stl/lid_r10_thin-frame-show-glass-border.stl
enclosure/stl/fitcheck_r10_thin-frame-show-glass-border.stl
enclosure/stl/shell_r09_slimmer-small-usb-snug-ribs.stl
enclosure/stl/lid_r09_slimmer-small-usb-snug-ribs.stl
enclosure/stl/shell_r08_trim-far-bezel-more-usb-up.stl
enclosure/stl/lid_r08_trim-far-bezel-more-usb-up.stl
enclosure/stl/fitcheck_r08_trim-far-bezel-more-usb-up.stl
enclosure/stl/lid_r07_rounded-usb-trim-far-bezel.stl
enclosure/stl/shell_r07_rounded-usb-trim-far-bezel.stl
enclosure/stl/lid_r06_buttons-out-key-window-looser-ribs.stl
enclosure/stl/lid_r05_quick-fitcheck.stl
enclosure/stl/shell_r05_quick-fitcheck.stl
enclosure/stl/fitcheck_r05_quick-fitcheck.stl
