jeffraines/battlebuddy/(commit log)

2026-10-11 Trim display test kit to three boards
    Claude-Session: https://claude.ai/code/session_01SxtFVzoSVDinNWYQygv5rN
2026-10-11 Pick T-Display S3 Touch as first prototype board
    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
2026-10-11 Add printable actual-size display cutout sheet
    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
2026-10-12 Note Good Display adapter details and front-light voltage setting
    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
2026-10-12 Document driver support per display and platform
    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
2026-10-25 Add counter core and T-Display-S3 Touch prototype firmware
    Portable C core: game profiles, grouped changes, undo history, with host
    tests. PlatformIO firmware for the LilyGO T-Display-S3 Touch using
    LovyanGFX (ST7789 parallel + CST816 touch), plus a host snapshot tool
    that renders the UI through the same drawing code.
    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
2026-10-25 Add menu, themes, two-player mode and Conquer/Hold scoring
    Core: up to two players per game, changes tagged with a kind (Riftbound
    Conquer/Hold) and tallied per player, undo reports what it reverted.
    Firmware: BOOT opens a touch menu (game, players, restart, sleep); KEY
    undoes with an on-screen confirmation; the circle key below the screen
    toggles the menu; per-game color themes; deep sleep after 10 minutes or
    on demand, keeping the game in RTC memory and waking on KEY.
    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
    [main.cpp, snapshot.cpp, ui.cpp]
2026-10-25 Record every Riftbound point; add point track, layouts and flip
    Core: profiles choose whether rapid changes are grouped. Riftbound
    doesn't group, so each Conquer/Hold is its own history entry right away.
    Firmware: per-player point track showing C/H slots in scoring order;
    two-player layouts (YOU left, YOU right, facing across a table with the
    opponent's half upside down); whole-screen flip; tile menu for the
    extra settings.
    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
    [main.cpp, snapshot.cpp, ui.cpp]
2026-10-25 Add 3-4 player quadrants and a Riftbound 2v2 team profile
    Core: up to four players; profiles set their max player count and
    whether counters are teams. New riftbound-2v2 profile: two team scores
    to 11 (target unconfirmed).
    Firmware: quadrant layout for 3-4 players (upright or with the top row
    facing across the table), a spare quarter showing game and battery with
    three players, TEAM A/B and P1-P4 labels, and a point track that sizes
    its slots to the win target.
    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
2026-10-25 Add best-of matches and a match timer
    Core: bb_match_t tracks a best-of-1/3/5 between two sides and each game's
    winner; bb_game_winner decides a game from win/lose thresholds.
    Firmware: menu tiles for Match (off/Bo1/Bo3/Bo5) and Timer (off/30/50/60
    min). A banner announces each game's winner and the match score; a tap
    records it and starts the next game or match. Score and countdown show in
    the header or a pill on the divider; the clock runs on the RTC so it
    survives sleep and turns red with a + when over time.
    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
2026-10-25 Add roadmap: personal device, tournament kit, open MCU and charging choices
    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
2026-10-25 Add dice roller
    Core: dice list (coin, d4-d20) and an unbiased roll using rejection
    sampling over any 32-bit random source, with tests.
    Firmware: dice screen opened from the menu or the circle key below the
    screen; pick a die, tap or press KEY to roll, with a short shuffle and
    the last rolls listed. Uses the ESP32 hardware RNG.
    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
    [main.cpp, snapshot.cpp, ui.cpp, ui.h]
2026-10-25 Add design principles: replaceable battery, repairable, spill-tolerant
    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
2026-10-25 Animate dice: tumbling spin, coin flip, landing pop
    Each die gets its own silhouette (triangle, square, diamond, kite,
    pentagon, hexagon) that spins and slows to a stop while faces flicker
    more and more slowly, then pops on landing with a glow on a max or 1.
    The coin flips edge-on. Numbers are sized to fit inside each shape, and
    the unclear side hints are replaced by ROLL / TAP / FLIP on the die.
    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
    [main.cpp, snapshot.cpp, ui.cpp, ui.h]
2026-10-25 Tighten tap targets and ignore touches around button presses
    Conquer/Hold respond only to taps on the button (plus 2 px), with a dead
    strip between paired buttons. Taps now act on release; a touch is
    cancelled if a physical button is pressed during it or within 250 ms
    before it, so a thumb grazing the screen while pressing a side button
    doesn't score. Auto-repeat on +/- still works while held.
    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
    [main.cpp, ui.cpp]
2026-10-25 Add game picker, Digimon memory gauge and Yu-Gi-Oh! number pad
    Core: profiles belong to a game family with named formats and declare an
    input style (counter, amount, gauge). New Digimon (shared memory gauge,
    -10..10) and Yu-Gi-Oh! (8000 LP) profiles; bb_gauge_owner works out
    whose turn it is, including at 0.
    Firmware: the Game tile opens a picker of games in their own colors;
    games with several formats burst open into format tiles. Digimon shows
    the gauge with tap-to-set, arrows and PASS. Yu-Gi-Oh! opens a number pad
    with damage, gain and halve; each entry is one undoable history entry.
    Claude-Session: https://claude.ai/code/session_0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
    [main.cpp, snapshot.cpp, ui.cpp]
2026-10-25 Per-game title fonts, Vivid look, and dice celebrations
    Each game's name uses its own font (serif, bold italic, Orbitron, script)
    and long names wrap onto two lines on picker tiles. A Look setting
    switches between the subdued palettes and a vivid variant with saturated
    colors and glowing text; the menu becomes a 3x3 grid to fit it.
    Dice: every landing gets a ring and sparks colored by how good the roll
    was; the top face on any die throws confetti and the bottom face embers,
    with a longer effect and a NAT callout in the header.
    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
2026-10-25 Per-die roll animations, spin-down d20 counter, who-won, menu pages
    - Each die shape rolls differently (hop, roll in, top spin, pendulum,
    arc toss, thrown toward you).
    - Counter setting: life on a d20 that spins a face toward each change.
    - End game asks who won when a match is on, so games the counter can't
    decide (Digimon, concessions) still count; or restart without a result.
    - Menu splits into two pages and gains Undo, Sleep and Counter.
    - Header lettering uses fonts made for its size (Digimon back to bold
    sans); FaB uses a short name in tight spots; Conquer/Hold labels get
    room inside their buttons.
    Claude-Session: https:/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
    [main.cpp, snapshot.cpp, ui.cpp, ui.h]
2026-10-25 Give Magic, Lorcana and FaB their own counter looks
    The Counter setting is now Themed (default), d20 or Digits. Themed:
    Magic and Commander life sits in a ring of five colored orbs that turns
    toward each change and flashes for damage or gain; Lorcana lore lights a
    diamond per point toward 20 with a sparkle on the newest; Flesh and
    Blood life sits on a bronze shield with a blood bar, shaking and
    flushing red when hit. Values roll like an odometer on every change and
    Yu-Gi-Oh! LP count to the new total.
    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
    [main.cpp, snapshot.cpp, ui.cpp, ui.h]
2026-10-25 Simplify the Magic counter to a row of five dots
    Replaces the orb ring with five small colored dots under the life total
    that ripple on a change, while the number briefly tints red for damage
    or green for gain. The rolling number is clipped above the dots.
    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
    [ui.cpp]
2026-10-25 Keep pending changes clear of themed counter frames
    With a themed or d20 counter in single-player mode, the pending change
    (+3, -4) and WIN/LOSE move to the top-right corner instead of under the
    number, where the Magic dots, Lorcana ring and FaB shield sit.
    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
2026-10-25 Keep Riftbound undo messages off the point track
    One player: the message sits under the big number. Two players side by
    side: it replaces the game name in the header. Either way the C/H slots
    it refers to stay visible.
    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
    [snapshot.cpp, ui.cpp]
2026-10-29 Add PCB v1 requirements: fuel gauge, replaceable battery, wireless charging
    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
2026-10-29 Record 6-8 hour battery life target for PCB v1
    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
2026-10-29 Battery target: 8 h minimum with screen always on, weekend goal
    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
2026-10-29 Note flat enclosure: device must read from both sides
    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
2026-11-08 Add 3D-printable prototype case for the LilyGO and an 803040 battery
    Parametric OpenSCAD shell with a front window, USB and button openings,
    and a battery bay under the board, closed by a screw-on lid so the
    battery can be swapped. Includes STLs and a quick fit-check frame.
    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
    [fitcheck.stl, lid.stl, lilygo_case.scad, shell.stl]
2026-11-08 Add printed press buttons and a reset pinhole to the case
    Plungers sit in the side wall with an inner block that keeps them in and
    presses the board's BOOT and KEY buttons; reset gets a recessed pinhole.
    Positions are parameters (defaults are guesses until measured); the fit
    check keeps long slots for finding them.
    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
    [buttons.stl, fitcheck.stl, lid.stl, lilygo_case.scad, shell.stl]
2026-11-08 Case: bigger USB-C opening, separator plate, buttons on any edge
    The USB-C opening grows to 13 x 8 mm with a thinned wall around it so
    plug housings can seat. The floor between board and battery becomes a
    separator plate with only a small wire notch. Buttons can go on either
    long edge or the far end, each cap sized to the gap behind it.
    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
    [fitcheck.stl, lid.stl, lilygo_case.scad, shell.stl]
2026-11-08 Case: face buttons either side of USB, 62 x 32 x 11 board
    The T-Display-S3 Touch's BOOT and KEY are on its face beside the USB
    port, so the front frame now covers that bare end of the board with two
    round press caps that sit on the buttons; the window covers only the
    glass and the USB opening is notched through the frame. Board size
    updated to the Touch version's 62 x 32 x 11 mm.
    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
    [buttons.stl, fitcheck.stl, lid.stl, lilygo_case.scad, shell.stl]
2026-11-08 Case: screen-only window, circle key hole, crush ribs, lower USB
    From the first fit-check print: the frame now covers the glass's black
    border and shows only the display (bevelled window) with a round hole
    for the circle touch key; crush ribs take up play; the USB opening goes
    lower; and the fit check keeps the button holes (they were missing).
    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
    [fitcheck.stl, lid.stl, lilygo_case.scad, shell.stl]
2026-11-08 Faster fit check: front frame with short walls plus the USB end
    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
    [fitcheck.stl, lilygo_case.scad]
2026-11-08 Name exported STLs by revision and description
    export.sh writes stl/<part>_rNN_<description>.stl and refuses to reuse a
    revision, so every print can be traced to its design. Current parts are
    exported as r05 (quick-fitcheck); the README lists the revisions.
    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
    [buttons_r05_quick-fitcheck.stl, fitcheck_r05_quick-fitcheck.stl, lid_r05_quick-fitcheck.stl, shell_r05_quick-fitcheck.stl]
2026-11-08 Enclosure README: revision-named files and revision list
    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
2026-11-08 Case r06: buttons further out, circle key in the window, looser ribs
    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
    [buttons_r06_buttons-out-key-window-looser-ribs.stl, fitcheck_r06_buttons-out-key-window-looser-ribs.stl, lid_r06_buttons-out-key-window-looser-ribs.stl, lilygo_case.scad, shell_r06_buttons-out-key-window-looser-ribs.stl]
2026-11-08 Case r07: rounded USB-C slot, hide the far-end bezel
    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
    [buttons_r07_rounded-usb-trim-far-bezel.stl, fitcheck_r07_rounded-usb-trim-far-bezel.stl, lid_r07_rounded-usb-trim-far-bezel.stl, lilygo_case.scad, shell_r07_rounded-usb-trim-far-bezel.stl]
2026-11-08 Case r08: hide more far-end bezel, centre USB slot on the port
    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
    [buttons_r08_trim-far-bezel-more-usb-up.stl, fitcheck_r08_trim-far-bezel-more-usb-up.stl, lid_r08_trim-far-bezel-more-usb-up.stl, lilygo_case.scad, shell_r08_trim-far-bezel-more-usb-up.stl]
2026-11-08 Case r09: slimmer case, small USB slot, snug ribs, buttons between r05 and r06
    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
    [buttons_r09_slimmer-small-usb-snug-ribs.stl, fitcheck_r09_slimmer-small-usb-snug-ribs.stl, lid_r09_slimmer-small-usb-snug-ribs.stl, lilygo_case.scad, shell_r09_slimmer-small-usb-snug-ribs.stl]
2026-11-08 Case r10: thin frame that shows the glass's black border
    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
    [buttons_r10_thin-frame-show-glass-border.stl, fitcheck_r10_thin-frame-show-glass-border.stl, lid_r10_thin-frame-show-glass-border.stl, lilygo_case.scad, shell_r10_thin-frame-show-glass-border.stl]
2026-11-09 Case r11: rounded window, cover the circle key, buttons in, USB lower
    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
    [buttons_r11_rounded-window-cover-key-buttons-in.stl, fitcheck_r11_rounded-window-cover-key-buttons-in.stl, lid_r11_rounded-window-cover-key-buttons-in.stl, lilygo_case.scad, shell_r11_rounded-window-cover-key-buttons-in.stl]
2026-11-09 Case r12: off-centre button holes, round notch for the circle key
    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
    [buttons_r12_asymmetric-buttons-key-notch.stl, fitcheck_r12_asymmetric-buttons-key-notch.stl, lid_r12_asymmetric-buttons-key-notch.stl, lilygo_case.scad, shell_r12_asymmetric-buttons-key-notch.stl]
2026-11-09 Case r13: curved window end over the circle key instead of a notch
    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
    [buttons_r13_curved-window-end-over-key.stl, fitcheck_r13_curved-window-end-over-key.stl, lid_r13_curved-window-end-over-key.stl, lilygo_case.scad, shell_r13_curved-window-end-over-key.stl]
2026-11-09 Case r14: straight window end up to the buttons, button nudges, key-covered variant
    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
    [buttons_r14_straight-window-to-buttons.stl, fitcheck_r14_straight-window-to-buttons.stl, fitcheck_r14_variant-key-covered.stl, lid_r14_straight-window-to-buttons.stl, lilygo_case.scad, shell_r14_straight-window-to-buttons.stl]
2026-11-09 Case r15: window tongue between the face buttons over the circle key
    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
    [buttons_r15_window-tongue-between-buttons.stl, fitcheck_r15_window-tongue-between-buttons.stl, lid_r15_window-tongue-between-buttons.stl, lilygo_case.scad, shell_r15_window-tongue-between-buttons.stl]
2026-11-09 Case r16: rounded window tongue, longer button plungers with length variants
    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
    [buttons_r16_rounded-tongue-longer-buttons.stl, buttons_r16_variant-longer-0.4mm.stl, buttons_r16_variant-shorter-0.4mm.stl, fitcheck_r16_rounded-tongue-longer-buttons.stl, lid_r16_rounded-tongue-longer-buttons.stl, lilygo_case.scad, shell_r16_rounded-tongue-longer-buttons.stl]
2026-11-09 Case r17: window back to the glass edge, slim round button plungers
    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
    [buttons_r17_variant-longer-0.4mm.stl, buttons_r17_variant-shorter-0.4mm.stl, buttons_r17_window-to-glass-slim-buttons.stl, fitcheck_r17_window-to-glass-slim-buttons.stl, lid_r17_window-to-glass-slim-buttons.stl, lilygo_case.scad, shell_r17_window-to-glass-slim-buttons.stl]
2026-11-09 Case r18: window closer to the buttons, D-shaped flange, longer plungers
    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
    [buttons_r18_variant-longer-0.5mm.stl, buttons_r18_variant-shorter-0.5mm.stl, buttons_r18_window-closer-d-flange-longer-buttons.stl, fitcheck_r18_window-closer-d-flange-longer-buttons.stl, lid_r18_window-closer-d-flange-longer-buttons.stl, lilygo_case.scad, shell_r18_window-closer-d-flange-longer-buttons.stl]
2026-11-10 Case r19: half flange, smaller caps, window as close to the buttons as possible
    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
    [buttons_r19_variant-longer-0.3mm.stl, buttons_r19_variant-shorter-0.3mm.stl, buttons_r19_window-to-buttons-half-flange.stl, fitcheck_r19_window-to-buttons-half-flange.stl, lid_r19_window-to-buttons-half-flange.stl, lilygo_case.scad, shell_r19_window-to-buttons-half-flange.stl]
2026-11-10 Case r20: buttons toward USB, shorter plungers, taller caps, snugger end ribs
    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
    [buttons_r20_buttons-toward-usb-shorter-taller-caps.stl, buttons_r20_variant-longer-0.3mm.stl, buttons_r20_variant-shorter-0.3mm.stl, fitcheck_r20_buttons-toward-usb-shorter-taller-caps.stl, lid_r20_buttons-toward-usb-shorter-taller-caps.stl, lilygo_case.scad, shell_r20_buttons-toward-usb-shorter-taller-caps.stl]
2026-11-14 Case r21: button nudges, window closer, reset pinhole
    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
    [buttons_r21_button-nudge-window-closer-reset-hole.stl, fitcheck_r21_button-nudge-window-closer-reset-hole.stl, lid_r21_button-nudge-window-closer-reset-hole.stl, lilygo_case.scad, shell_r21_button-nudge-window-closer-reset-hole.stl]
2026-11-14 Case r22: full-case print, buttons up, thicker wall by the window
    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
    [buttons_r22_final-print-buttons-up-thicker-web.stl, buttons_r22_variant-longer-0.3mm.stl, buttons_r22_variant-shorter-0.3mm.stl, fitcheck_r22_final-print-buttons-up-thicker-web.stl, lid_r22_final-print-buttons-up-thicker-web.stl, lilygo_case.scad, shell_r22_final-print-buttons-up-thicker-web.stl]
2026-11-14 Case r23: flexing press tab for the reset switch
    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
    [buttons_r23_flex-reset-button.stl, fitcheck_r23_flex-reset-button.stl, lid_r23_flex-reset-button.stl, lilygo_case.scad, shell_r23_flex-reset-button.stl]
2026-11-14 Case r24: split into body, snap-on faceplate and drop-in separator; bump on reset tab
    The one-piece shell had a fixed separator below the board and a fixed front
    frame above it, so the board could not be put in.
    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
    [body_r24_split-faceplate-body-separator.stl, buttons_r24_split-faceplate-body-separator.stl, faceplate_r24_split-faceplate-body-separator.stl, lid_r24_split-faceplate-body-separator.stl, lilygo_case.scad, separator_r24_split-faceplate-body-separator.stl]
